PJO83/icenes/hw/icenes.kicad_pcb

## KiCad design hw/icenes.kicad_pcb (2019-10-22)

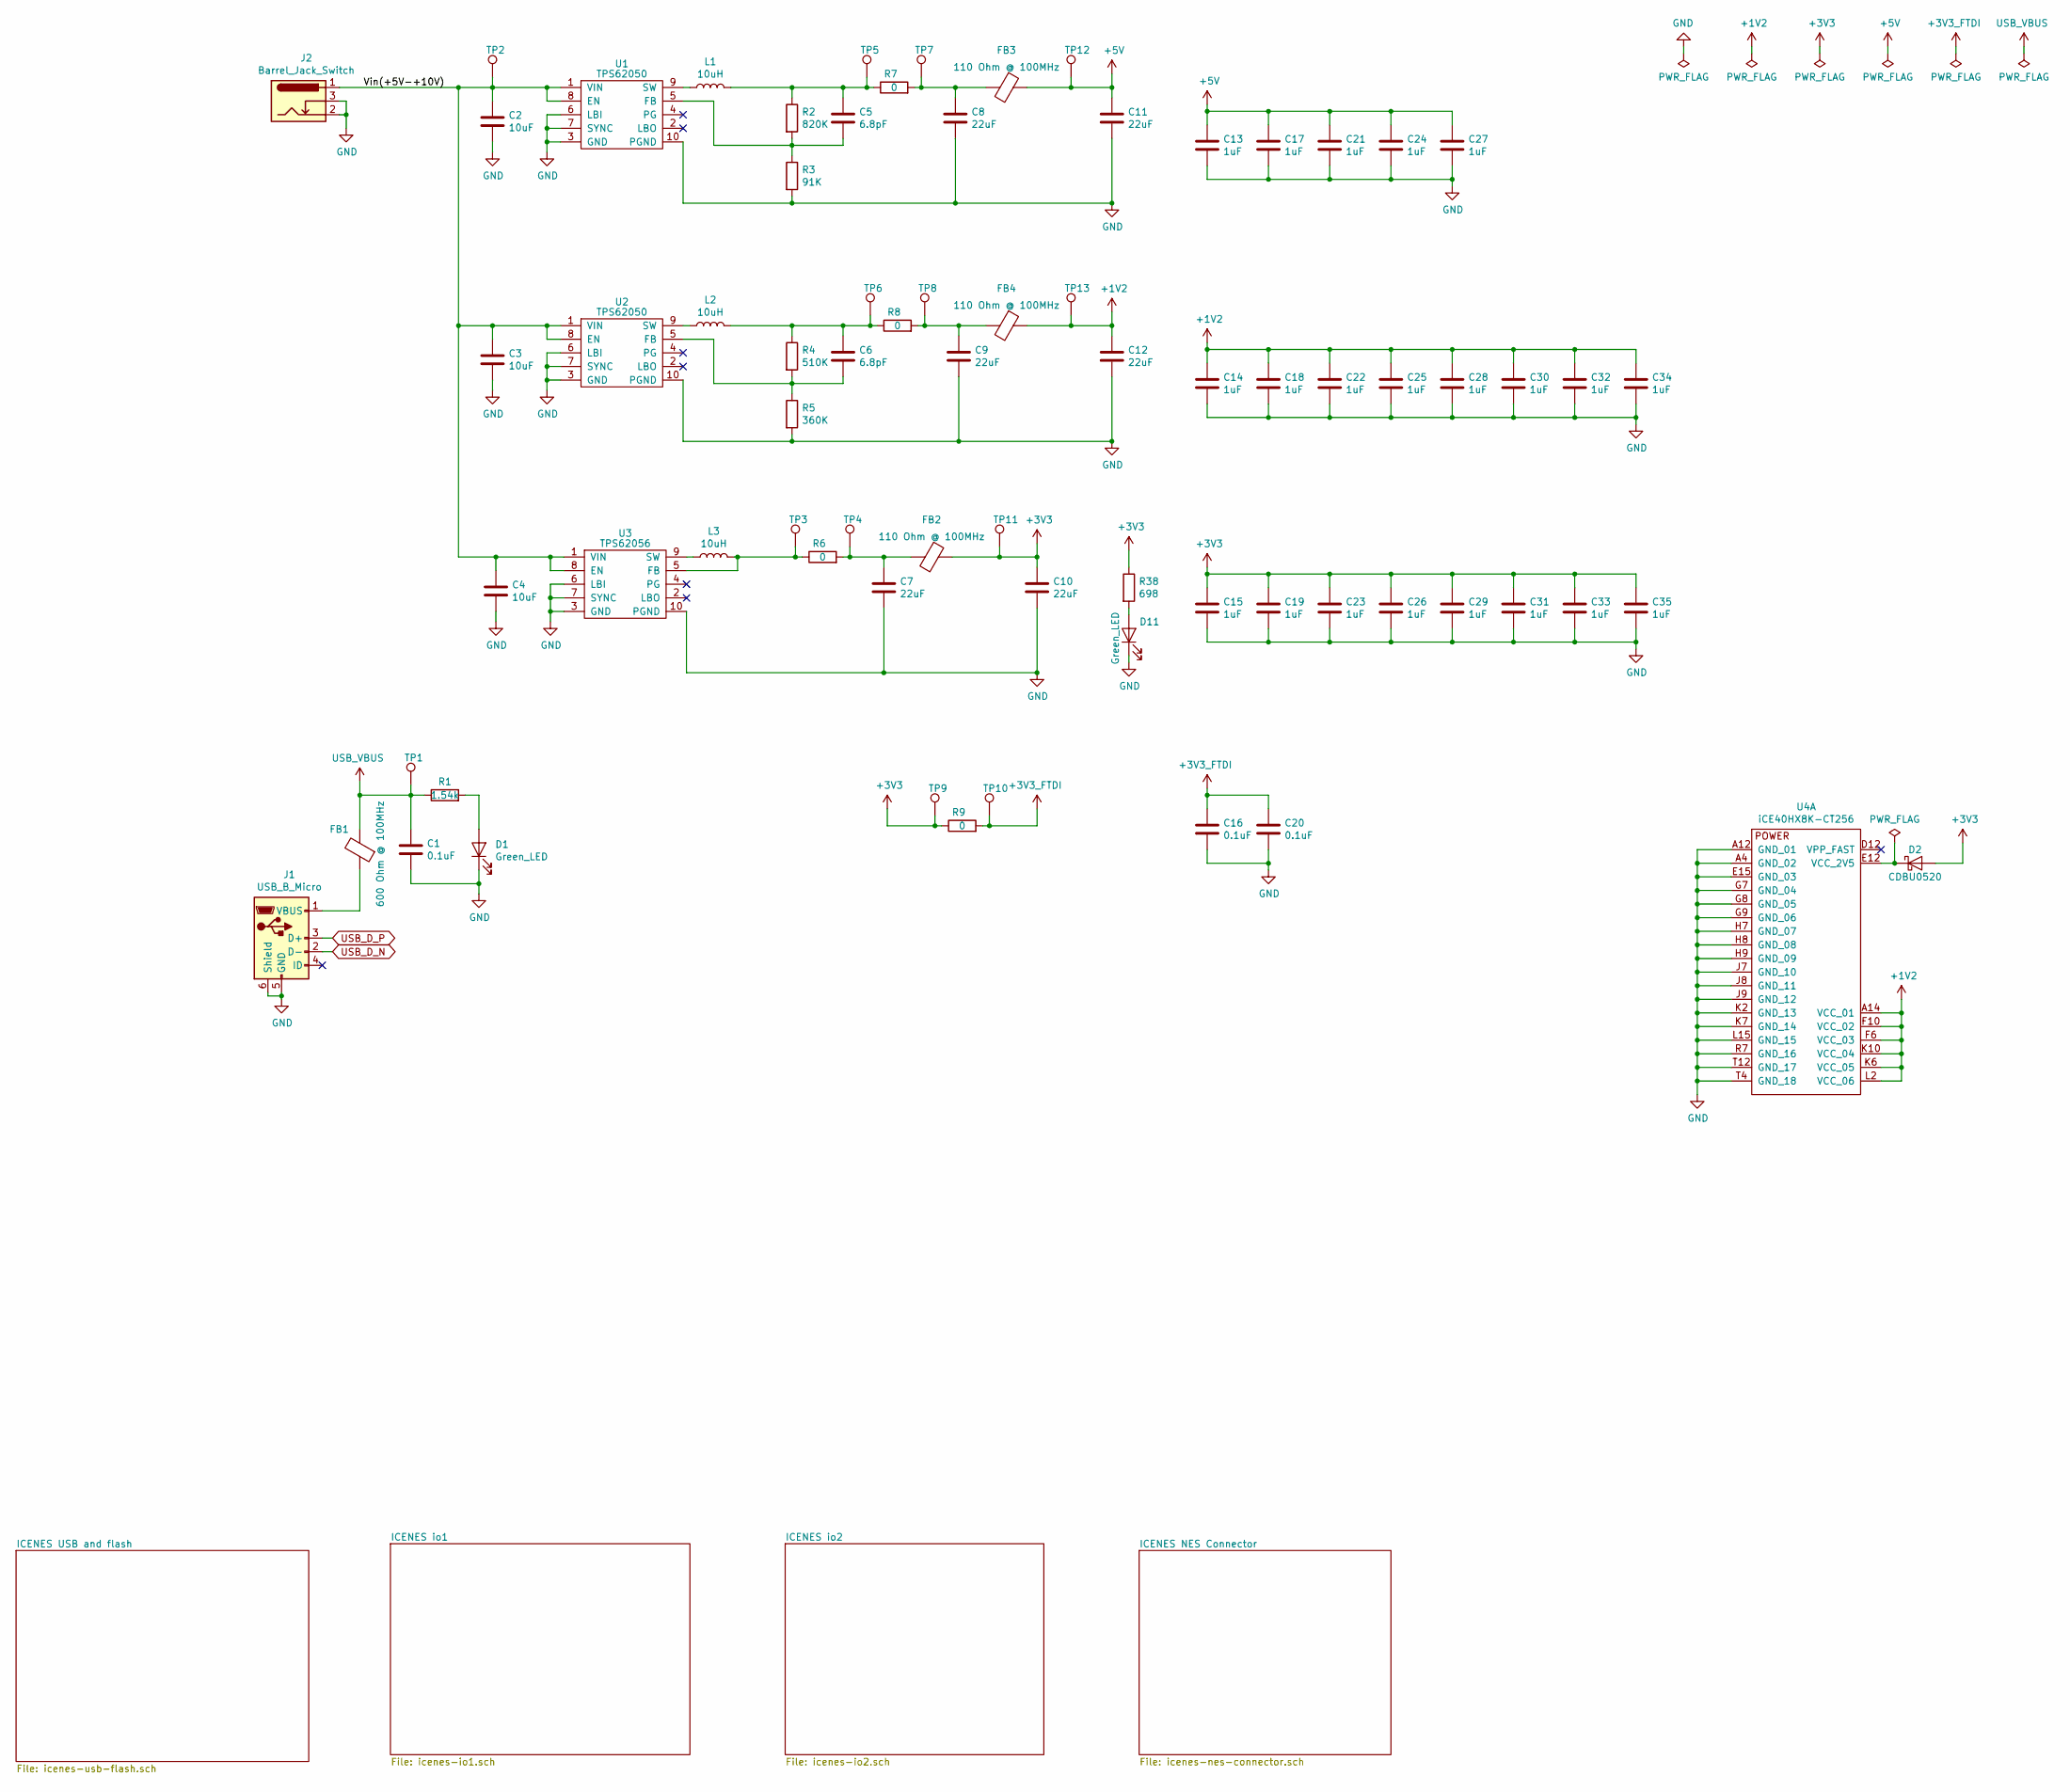
[picture p1: schematic icenes.sch, ICENES Power]

Parts:
C1, C16, C20: C0.1uF; C_0603_1608Metric_Pad1.05x0.95mm_HandSolder; Part number 885012206020
C2, C3, C4: C10uF; C_0603_1608Metric_Pad1.05x0.95mm_HandSolder; Part number GRM188R61A106KE69D
C5, C6: C6.8pF; C_0603_1608Metric_Pad1.05x0.95mm_HandSolder; Part number VJ0603A6R8DXQCW1BC
C7, C8, C9, C10, C11, C12: C22uF; C_0603_1608Metric_Pad1.05x0.95mm_HandSolder; Part number GRM188R61A226ME15D
C13, C14, C15, C17, C18, C19, C21, C22, C23, C24, C25, C26, C27, C28, C29, C30, C31, C32, C33, C34, C35: C1uF; C_0603_1608Metric_Pad1.05x0.95mm_HandSolder; Part number C0603C105K8PACTU
D1, D11: Green_LED; LED_0805_2012Metric_Pad1.15x1.40mm_HandSolder; Part number APTD2012LCGCK
D2: CDBU0520; D_0603_1608Metric_Pad1.05x0.95mm_HandSolder; Part number CDBU0520
FB1: FB600_500mA_0603; L_0603_1608Metric_Pad1.05x0.95mm_HandSolder; Part number KMZ1608BHR601CTDH5
FB2, FB3, FB4: FB110_4100mA_0603; L_0603_1608Metric_Pad1.05x0.95mm_HandSolder; Part number 74279228111
J1: USB_B_Micro; USB_Micro-B; Part number DX4R005JJ2R1800
J2: Barrel_Jack_Switch; BarrelJack_Horizontal; Part number 163-179PH-EX
L1, L2, L3: L10uH; Sumida_L_7.5x7.5_H4.5; Part number CDRH74NP-100MC-B
R1: R1.54k; R_0603_1608Metric_Pad1.05x0.95mm_HandSolder; Part number RC0603FR-071K54L
R2: R820K; R_0603_1608Metric_Pad1.05x0.95mm_HandSolder; Part number RC0603FR-07820KL
R3: R91K; R_0603_1608Metric_Pad1.05x0.95mm_HandSolder; Part number RC0603FR-0791KL
R4: R510K; R_0603_1608Metric_Pad1.05x0.95mm_HandSolder; Part number RC0603FR-07510KL
R5: R360K; R_0603_1608Metric_Pad1.05x0.95mm_HandSolder; Part number RC0603FR-07360KL
R6, R7, R8, R9: R0; R_0805_2012Metric_Pad1.15x1.40mm_HandSolder; Part number RC0805FR-070RL
R38: R698; R_0603_1608Metric_Pad1.05x0.95mm_HandSolder; Part number RC0603FR-07698RL
TP1, TP2, TP3, TP4, TP5, TP6, TP7, TP8, TP9, TP10, TP11, TP12, TP13: TestPoint; TestPoint_Pad_D1.0mm
U1, U2: TPS62050; VSSOP-10_3x3mm_P0.5mm; Part number TPS62050DGSR
U3: TPS62056; VSSOP-10_3x3mm_P0.5mm; Part number TPS62056DGSR
U4: iCE40HX8K-CT256; BGA-256_14.0x14.0mm_Layout16x16_P0.8mm_Ball0.45mm_Pad0.32mm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; Part number iCE40HX8K-CT256

Connections:
+1V2: C12.1, C14.1, C18.1, C22.1, C25.1, C28.1, C30.1, C32.1, C34.1, FB4.1, TP13.1, U4.A14 (VCC_01), U4.F6 (VCC_03), U4.F10 (VCC_02), U4.K6 (VCC_05), U4.K10 (VCC_04), U4.L2 (VCC_06); also elsewhere on the board
+3V3: C10.1, C15.1, C19.1, C23.1, C26.1, C29.1, C31.1, C33.1, C35.1, D2.2 (A), FB2.1, R9.1, R38.1, TP9.1, TP11.1; also elsewhere on the board
+3V3_FTDI: C16.1, C20.1, R9.2, TP10.1; also elsewhere on the board
+5V: C11.1, C13.1, C17.1, C21.1, C24.1, C27.1, FB3.1, TP12.1; also elsewhere on the board
/Vin(+5V-+10V): C2.1, C3.1, C4.1, J2.1, TP2.1, U1.1 (VIN), U1.8 (EN), U2.1 (VIN), U2.8 (EN), U3.1 (VIN), U3.8 (EN)
GND: C1.2, C2.2, C3.2, C4.2, C7.2, C8.2, C9.2, C10.2, C11.2, C12.2, C13.2, C14.2, C15.2, C16.2, C17.2, C18.2, C19.2, C20.2, C21.2, C22.2, C23.2, C24.2, C25.2, C26.2, C27.2, C28.2, C29.2, C30.2, C31.2, C32.2, C33.2, C34.2, C35.2, D1.1 (K), D11.1 (K), J1.5 (GND), J1.6 (Shield), J2.2, J2.3, R3.2, R5.2, U1.3 (GND), U1.6 (LBI), U1.7 (SYNC), U1.10 (PGND), U2.3 (GND), U2.6 (LBI), U2.7 (SYNC), U2.10 (PGND), U3.3 (GND), U3.6 (LBI), U3.7 (SYNC), U3.10 (PGND), U4.A4 (GND_02), U4.A12 (GND_01), U4.E15 (GND_03), U4.G7 (GND_04), U4.G8 (GND_05), U4.G9 (GND_06), U4.H7 (GND_07), U4.H8 (GND_08), U4.H9 (GND_09), U4.J7 (GND_10), U4.J8 (GND_11), U4.J9 (GND_12), U4.K2 (GND_13), U4.K7 (GND_14), U4.L15 (GND_15), U4.R7 (GND_16), U4.T4 (GND_18), U4.T12 (GND_17); also elsewhere on the board
unnamed: C5.1, L1.2, R2.1, R7.1, TP5.1
unnamed: C5.2, R2.2, R3.1, U1.5 (FB)
unnamed: C6.1, L2.2, R4.1, R8.1, TP6.1
unnamed: C6.2, R4.2, R5.1, U2.5 (FB)
unnamed: C7.1, FB2.2, R6.2, TP4.1
unnamed: C8.1, FB3.2, R7.2, TP7.1
unnamed: C9.1, FB4.2, R8.2, TP8.1
unnamed: D1.2 (A), R1.2
unnamed: D2.1 (K), U4.E12 (VCC_2V5)
unnamed: D11.2 (A), R38.2
unnamed: FB1.1, J1.1 (VBUS)
unnamed: L1.1, U1.9 (SW)
unnamed: L2.1, U2.9 (SW)
unnamed: L3.1, U3.9 (SW)
unnamed: L3.2, R6.1, TP3.1, U3.5 (FB)
USB_D_N: J1.2 (D-); also elsewhere on the board
USB_D_P: J1.3 (D+); also elsewhere on the board
USB_VBUS: C1.1, FB1.2, R1.1, TP1.1; also elsewhere on the board

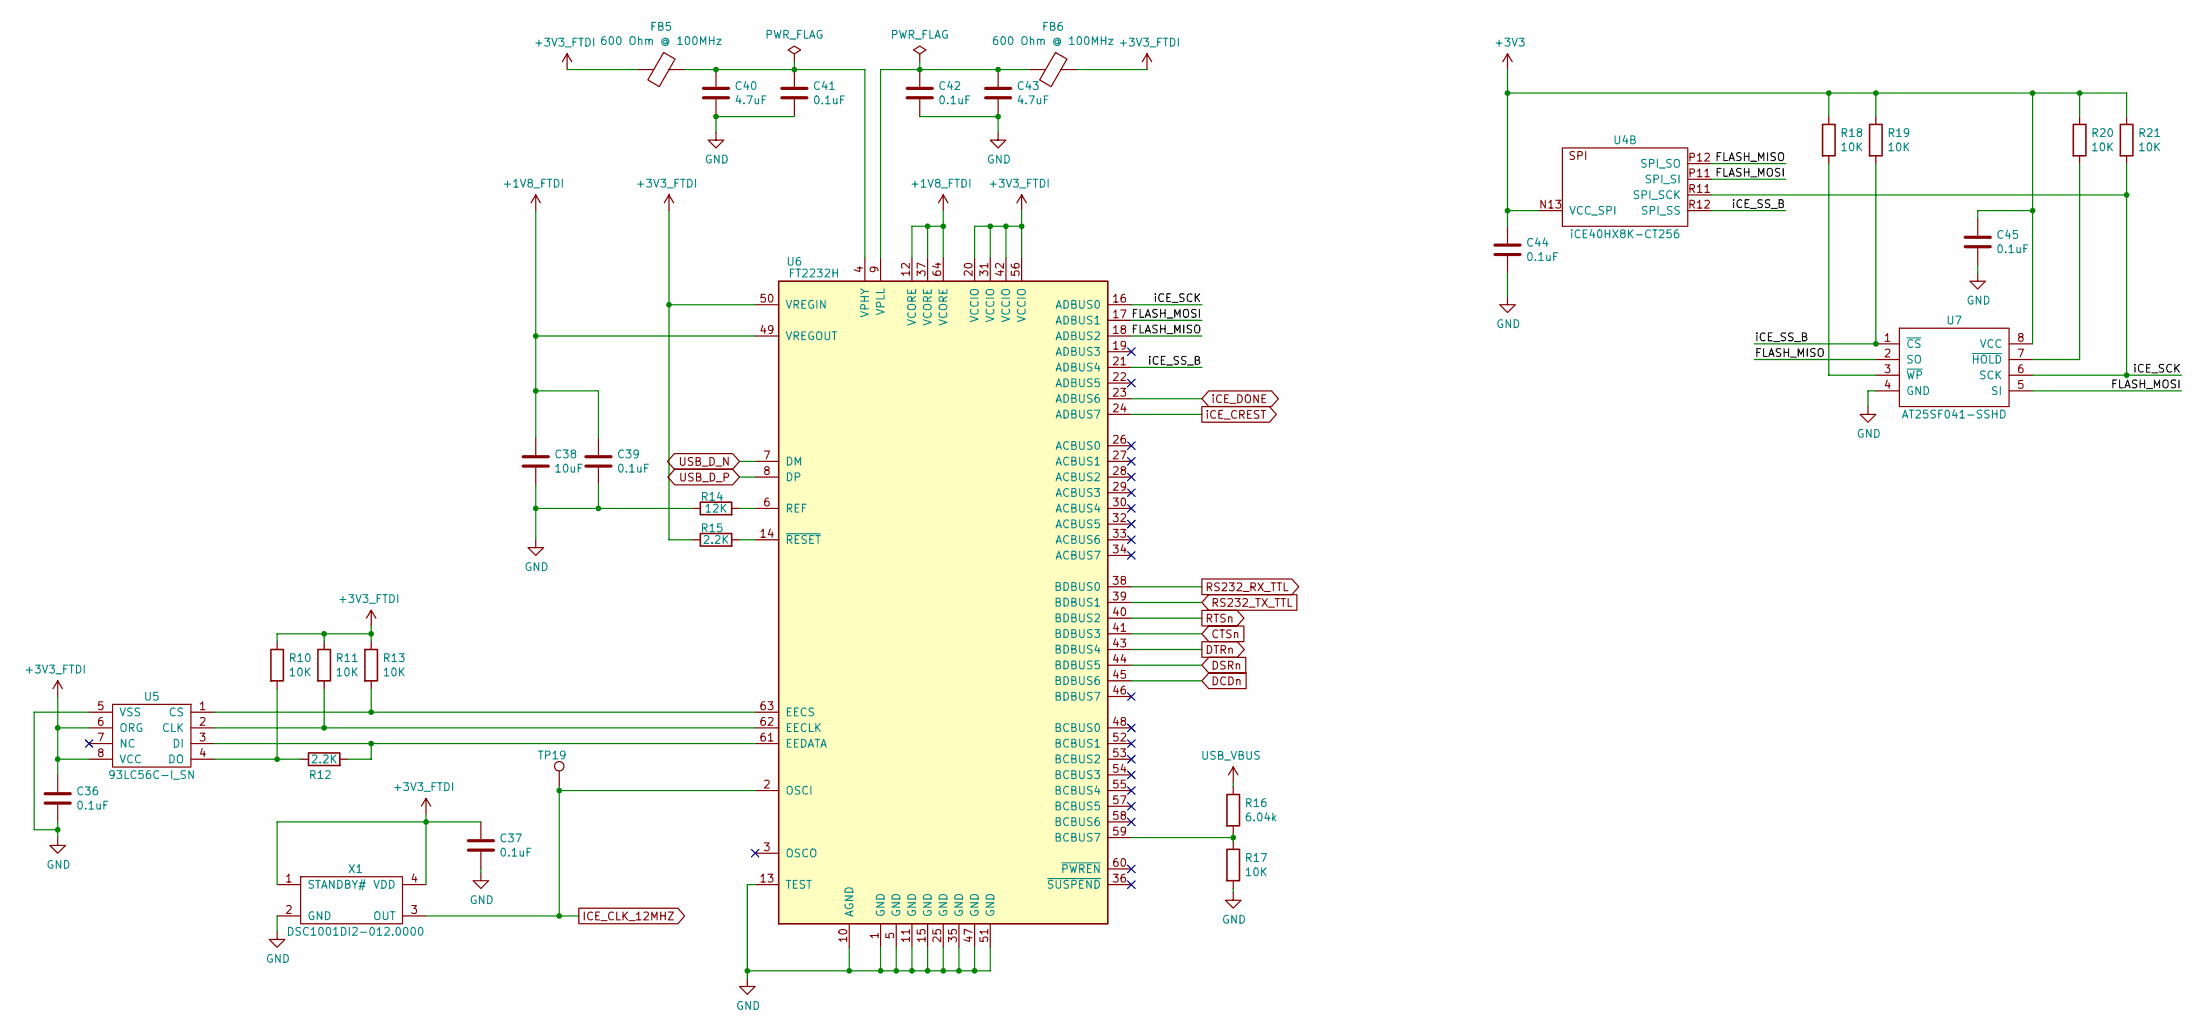
[picture p2: schematic icenes-usb-flash.sch]

Parts:
C36, C37, C39, C41, C42, C44, C45: C0.1uF; C_0603_1608Metric_Pad1.05x0.95mm_HandSolder; Part number 885012206020
C38: C10uF; C_0603_1608Metric_Pad1.05x0.95mm_HandSolder; Part number GRM188R61A106KE69D
C40, C43: C4.7uF; C_0603_1608Metric_Pad1.05x0.95mm_HandSolder; Part number LMK107BJ475KA-T
FB5, FB6: FB600_500mA_0603; L_0603_1608Metric_Pad1.05x0.95mm_HandSolder; Part number KMZ1608BHR601CTDH5
R10, R11, R13, R17, R18, R19, R20, R21: R10K; R_0603_1608Metric_Pad1.05x0.95mm_HandSolder; Part number RC0603FR-0710KL
R12, R15: R2.2K; R_0603_1608Metric_Pad1.05x0.95mm_HandSolder; Part number RC0603FR-072K2L
R14: R12K; R_0603_1608Metric_Pad1.05x0.95mm_HandSolder; Part number RC0603FR-0712KL
R16: R6.04k; R_0603_1608Metric_Pad1.05x0.95mm_HandSolder; Part number RC0603FR-076K04L
TP19: TestPoint; TestPoint_Pad_D1.0mm
U4: iCE40HX8K-CT256; BGA-256_14.0x14.0mm_Layout16x16_P0.8mm_Ball0.45mm_Pad0.32mm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; Part number iCE40HX8K-CT256
U5: 93LC56C-I_SN; SOIC-8_3.9x4.9mm_P1.27mm; Part number 93LC56C-I/SN
U6: FT2232H; LQFP-64_10x10mm_P0.5mm; Part number FT2232HL
U7: AT25SF041-SSHD; SOIC-8_3.9x4.9mm_P1.27mm; Part number AT25SF041-SSHD-B
X1: DSC1001DI2-012.0000; MEMS_Microship_Ocillator_SMD_CDFN-4_2.5x2.0mm; Part number DSC1001DI2-012.0000T

Connections:
+1V8_FTDI: C38.1, C39.1, U6.12 (VCORE), U6.37 (VCORE), U6.49 (VREGOUT), U6.64 (VCORE)
+3V3: C44.1, C45.1, R18.1, R19.1, R20.1, R21.1, U4.N13 (VCC_SPI), U7.8 (VCC); also elsewhere on the board
+3V3_FTDI: C36.1, C37.1, FB5.2, FB6.1, R10.1, R11.1, R13.1, R15.1, U5.6 (ORG), U5.8 (VCC), U6.20 (VCCIO), U6.31 (VCCIO), U6.42 (VCCIO), U6.50 (VREGIN), U6.56 (VCCIO), X1.1 (STANDBY#), X1.4 (VDD); also elsewhere on the board
/ICENES USB and flash/FLASH_MISO: U4.P12 (SPI_SO), U6.18 (ADBUS2), U7.2 (SO)
/ICENES USB and flash/FLASH_MOSI: U4.P11 (SPI_SI), U6.17 (ADBUS1), U7.5 (SI)
/ICENES USB and flash/iCE_SCK: R21.2, U4.R11 (SPI_SCK), U6.16 (ADBUS0), U7.6 (SCK)
/ICENES USB and flash/iCE_SS_B: R19.2, U4.R12 (SPI_SS), U6.21 (ADBUS4), U7.1 (~CS)
CTSn: U6.41 (BDBUS3); also elsewhere on the board
DCDn: U6.45 (BDBUS6); also elsewhere on the board
DSRn: U6.44 (BDBUS5); also elsewhere on the board
DTRn: U6.43 (BDBUS4); also elsewhere on the board
GND: C36.2, C37.2, C38.2, C39.2, C40.2, C41.2, C42.2, C43.2, C44.2, C45.2, R14.1, R17.2, U5.5 (VSS), U6.1 (GND), U6.5 (GND), U6.10 (AGND), U6.11 (GND), U6.13 (TEST), U6.15 (GND), U6.25 (GND), U6.35 (GND), U6.47 (GND), U6.51 (GND), U7.4 (GND), X1.2 (GND); also elsewhere on the board
ICE_CLK_12MHZ: TP19.1, U6.2 (OSCI), X1.3 (OUT); also elsewhere on the board
unnamed: C40.1, C41.1, FB5.1, U6.4 (VPHY)
unnamed: C42.1, C43.1, FB6.2, U6.9 (VPLL)
unnamed: R10.2, R12.1, U5.4 (DO)
unnamed: R11.2, U5.2 (CLK), U6.62 (EECLK)
unnamed: R12.2, U5.3 (DI), U6.61 (EEDATA)
unnamed: R13.2, U5.1 (CS), U6.63 (EECS)
unnamed: R14.2, U6.6 (REF)
unnamed: R15.2, U6.14 (~RESET)
unnamed: R16.2, R17.1, U6.59 (BCBUS7)
unnamed: R18.2, U7.3 (~WP)
unnamed: R20.2, U7.7 (~HOLD)
RS232_RX_TTL: U6.38 (BDBUS0); also elsewhere on the board
RS232_TX_TTL: U6.39 (BDBUS1); also elsewhere on the board
RTSn: U6.40 (BDBUS2); also elsewhere on the board
USB_D_N: U6.7 (DM); also elsewhere on the board
USB_D_P: U6.8 (DP); also elsewhere on the board
USB_VBUS: R16.1; also elsewhere on the board
iCE_CREST: U6.24 (ADBUS7); also elsewhere on the board
iCE_DONE: U6.23 (ADBUS6); also elsewhere on the board

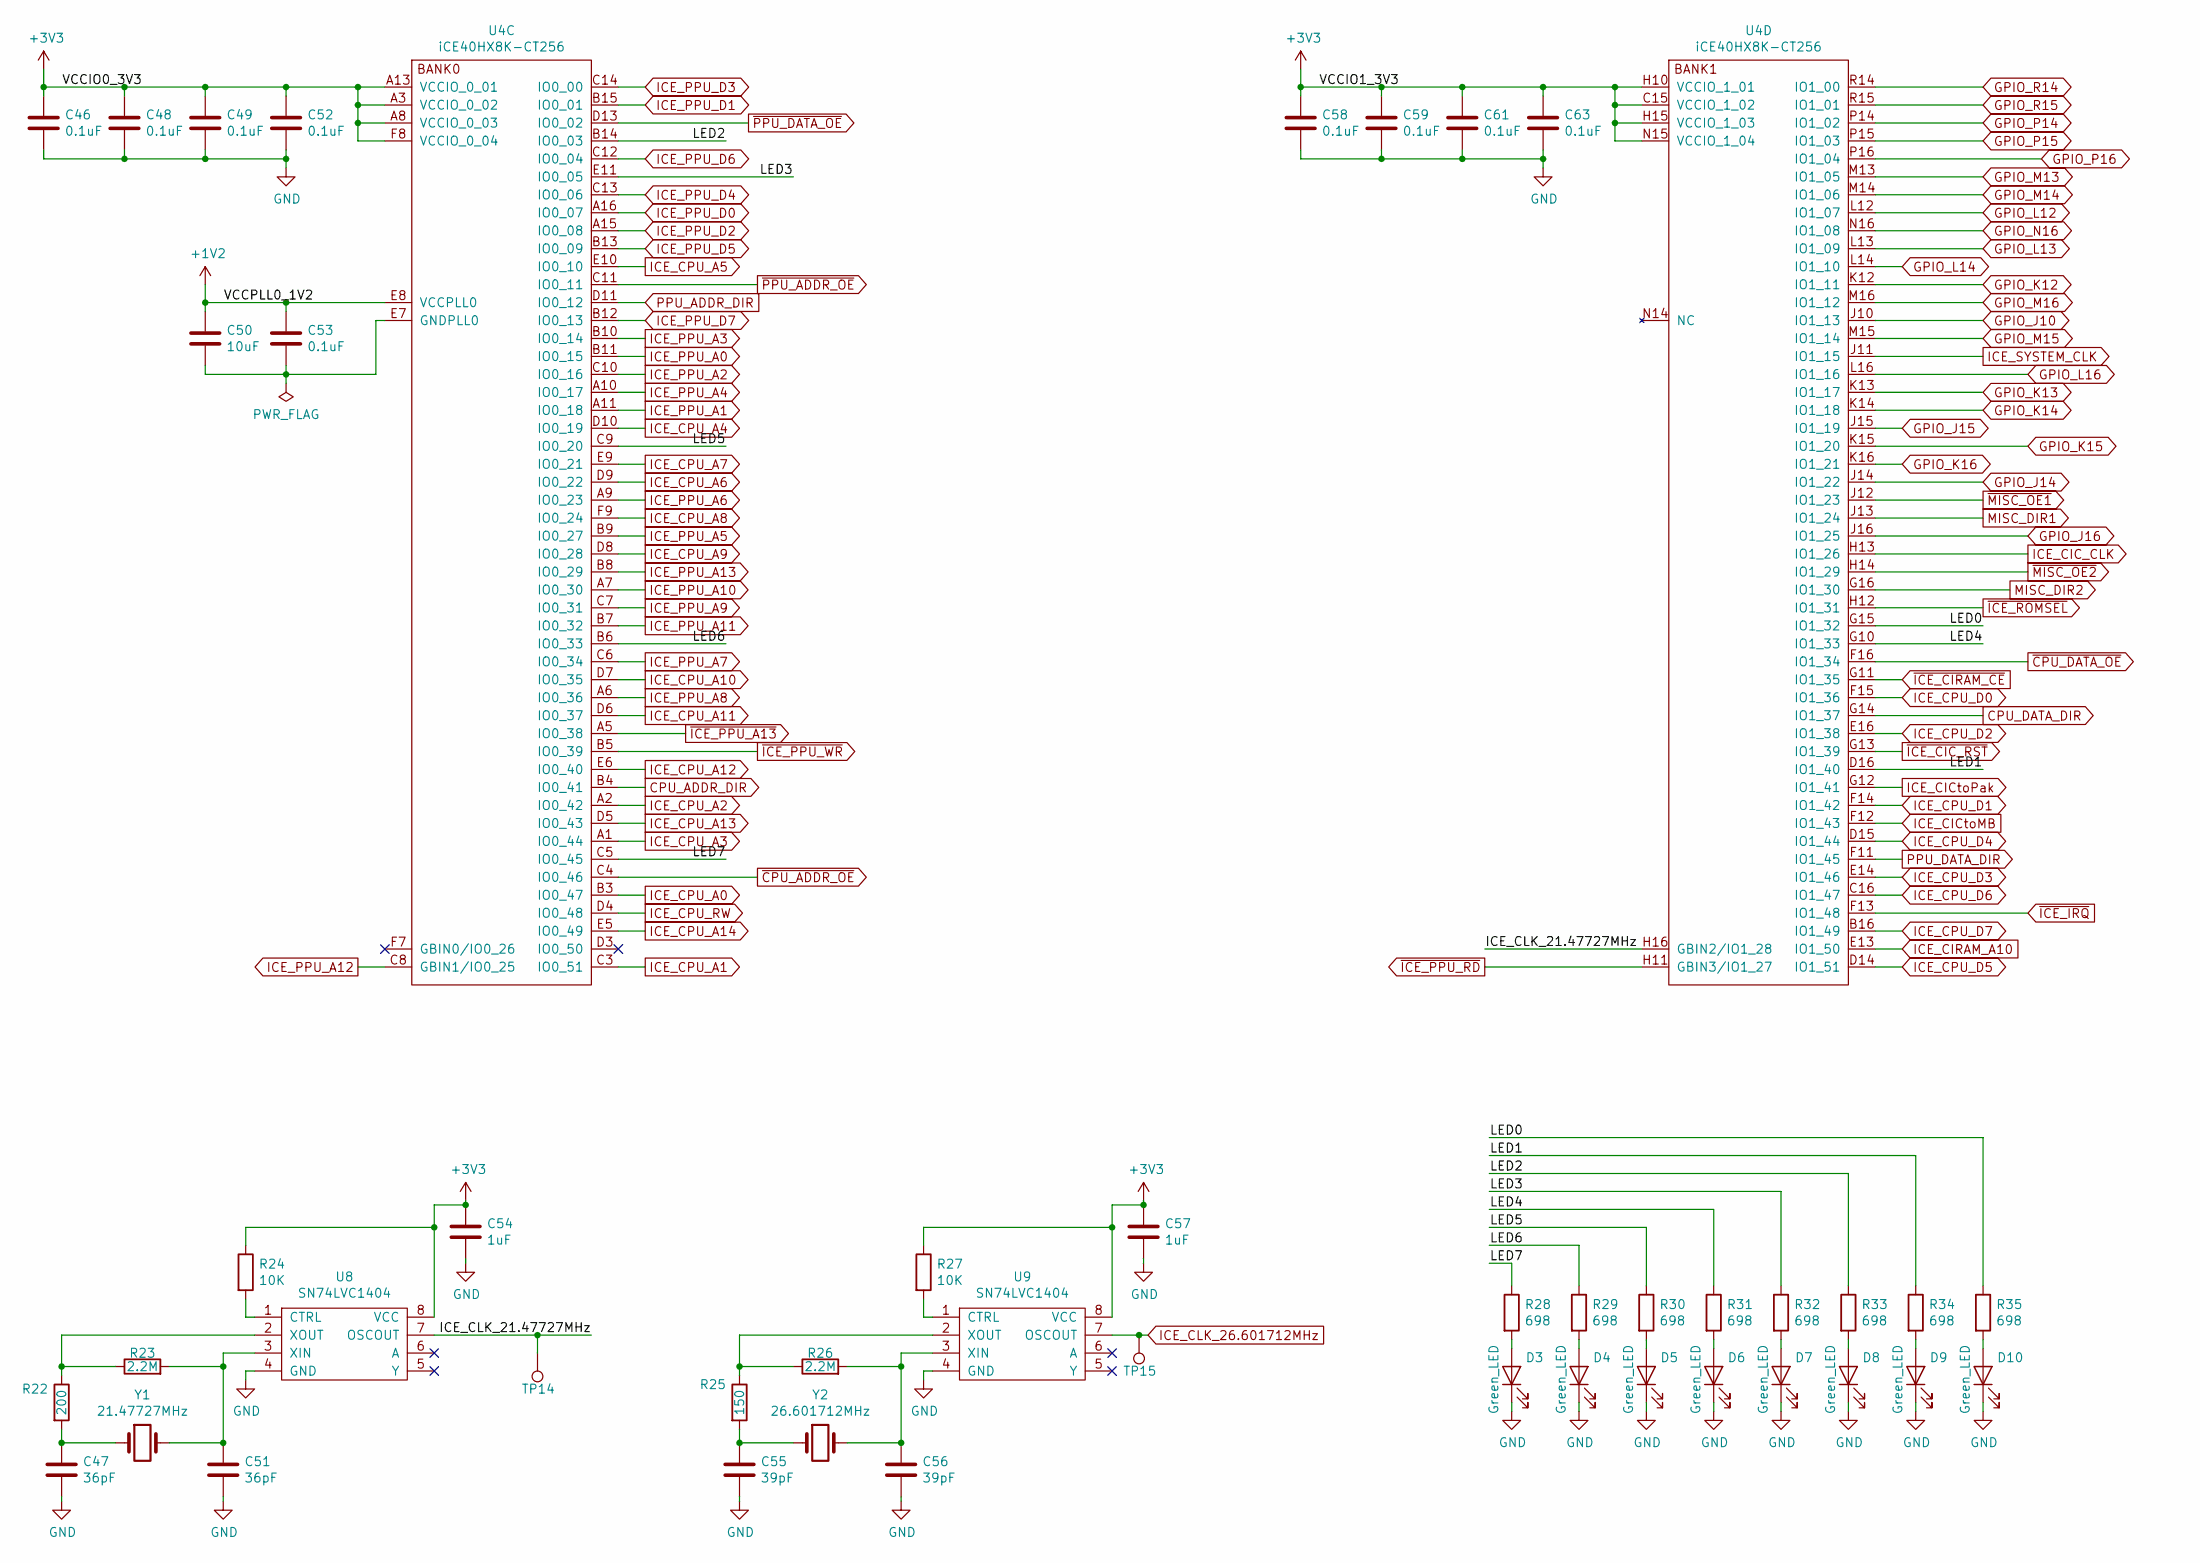
[picture p3: schematic icenes-io1.sch]

Parts:
C46, C48, C49, C52, C53, C58, C59, C61, C63: C0.1uF; C_0603_1608Metric_Pad1.05x0.95mm_HandSolder; Part number 885012206020
C47, C51: C36pF; C_0603_1608Metric_Pad1.05x0.95mm_HandSolder; Part number CC0603FRNPO9BN360
C50: C10uF; C_0603_1608Metric_Pad1.05x0.95mm_HandSolder; Part number GRM188R61A106KE69D
C54, C57: C1uF; C_0603_1608Metric_Pad1.05x0.95mm_HandSolder; Part number C0603C105K8PACTU
C55, C56: C39pF; C_0603_1608Metric_Pad1.05x0.95mm_HandSolder; Part number CC0603FRNPO9BN390
D3, D4, D5, D6, D7, D8, D9, D10: Green_LED; LED_0805_2012Metric_Pad1.15x1.40mm_HandSolder; Part number APTD2012LCGCK
R22: R200; R_0603_1608Metric_Pad1.05x0.95mm_HandSolder; Part number RC0603FR-07200RL
R23, R26: R2.2M; R_0603_1608Metric_Pad1.05x0.95mm_HandSolder; Part number RC0603FR-072M2L
R24, R27: R10K; R_0603_1608Metric_Pad1.05x0.95mm_HandSolder; Part number RC0603FR-0710KL
R25: R150; R_0603_1608Metric_Pad1.05x0.95mm_HandSolder; Part number RC0603FR-07150RL
R28, R29, R30, R31, R32, R33, R34, R35: R698; R_0603_1608Metric_Pad1.05x0.95mm_HandSolder; Part number RC0603FR-07698RL
TP14, TP15: TestPoint; TestPoint_Pad_D1.0mm
U4: iCE40HX8K-CT256; BGA-256_14.0x14.0mm_Layout16x16_P0.8mm_Ball0.45mm_Pad0.32mm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; Part number iCE40HX8K-CT256
U8, U9: SN74LVC1404; VSSOP-8_2.3x2mm_P0.5mm; Part number SN74LVC1404DCUR
Y1: 21.47727MHz; Crystal_HC49-4H_Vertical; Part number HC-49/U-S21477270ABJB
Y2: 26.601712MHz; Crystal_HC49-4H_Vertical; Part number ?

Connections:
+1V2: C50.1, C53.1, U4.E8 (VCCPLL0); also elsewhere on the board
+3V3: C46.1, C48.1, C49.1, C52.1, C54.1, C57.1, C58.1, C59.1, C61.1, C63.1, R24.1, R27.1, U4.A3 (VCCIO_0_02), U4.A8 (VCCIO_0_03), U4.A13 (VCCIO_0_01), U4.C15 (VCCIO_1_02), U4.F8 (VCCIO_0_04), U4.H10 (VCCIO_1_01), U4.H15 (VCCIO_1_03), U4.N15 (VCCIO_1_04), U8.8 (VCC), U9.8 (VCC); also elsewhere on the board
/ICENES io1/ICE_CLK_21.47727MHz: TP14.1, U4.H16 (GBIN2/IO1_28), U8.7 (OSCOUT)
/ICENES io1/LED0: R35.1, U4.G15 (IO1_32)
/ICENES io1/LED1: R34.1, U4.D16 (IO1_40)
/ICENES io1/LED2: R33.1, U4.B14 (IO0_03)
/ICENES io1/LED3: R32.1, U4.E11 (IO0_05)
/ICENES io1/LED4: R31.1, U4.G10 (IO1_33)
/ICENES io1/LED5: R30.1, U4.C9 (IO0_20)
/ICENES io1/LED6: R29.1, U4.B6 (IO0_33)
/ICENES io1/LED7: R28.1, U4.C5 (IO0_45)
CPU_ADDR_DIR: U4.B4 (IO0_41); also elsewhere on the board
CPU_DATA_DIR: U4.G14 (IO1_37); also elsewhere on the board
GND: C46.2, C47.2, C48.2, C49.2, C51.2, C52.2, C54.2, C55.2, C56.2, C57.2, C58.2, C59.2, C61.2, C63.2, D3.1 (K), D4.1 (K), D5.1 (K), D6.1 (K), D7.1 (K), D8.1 (K), D9.1 (K), D10.1 (K), U8.4 (GND), U9.4 (GND); also elsewhere on the board
GPIO_J10: U4.J10 (IO1_13); also elsewhere on the board
GPIO_J14: U4.J14 (IO1_22); also elsewhere on the board
GPIO_J15: U4.J15 (IO1_19); also elsewhere on the board
GPIO_J16: U4.J16 (IO1_25); also elsewhere on the board
GPIO_K12: U4.K12 (IO1_11); also elsewhere on the board
GPIO_K13: U4.K13 (IO1_17); also elsewhere on the board
GPIO_K14: U4.K14 (IO1_18); also elsewhere on the board
GPIO_K15: U4.K15 (IO1_20); also elsewhere on the board
GPIO_K16: U4.K16 (IO1_21); also elsewhere on the board
GPIO_L12: U4.L12 (IO1_07); also elsewhere on the board
GPIO_L13: U4.L13 (IO1_09); also elsewhere on the board
GPIO_L14: U4.L14 (IO1_10); also elsewhere on the board
GPIO_L16: U4.L16 (IO1_16); also elsewhere on the board
GPIO_M13: U4.M13 (IO1_05); also elsewhere on the board
GPIO_M14: U4.M14 (IO1_06); also elsewhere on the board
GPIO_M15: U4.M15 (IO1_14); also elsewhere on the board
GPIO_M16: U4.M16 (IO1_12); also elsewhere on the board
GPIO_N16: U4.N16 (IO1_08); also elsewhere on the board
GPIO_P14: U4.P14 (IO1_02); also elsewhere on the board
GPIO_P15: U4.P15 (IO1_03); also elsewhere on the board
GPIO_P16: U4.P16 (IO1_04); also elsewhere on the board
GPIO_R14: U4.R14 (IO1_00); also elsewhere on the board
GPIO_R15: U4.R15 (IO1_01); also elsewhere on the board
ICE_CIC_CLK: U4.H13 (IO1_26); also elsewhere on the board
ICE_CICtoMB: U4.F12 (IO1_43); also elsewhere on the board
ICE_CICtoPak: U4.G12 (IO1_41); also elsewhere on the board
ICE_CIRAM_A10: U4.E13 (IO1_50); also elsewhere on the board
ICE_CLK_26.601712MHz: TP15.1, U9.7 (OSCOUT); also elsewhere on the board
ICE_CPU_A0: U4.B3 (IO0_47); also elsewhere on the board
ICE_CPU_A1: U4.C3 (IO0_51); also elsewhere on the board
ICE_CPU_A2: U4.A2 (IO0_42); also elsewhere on the board
ICE_CPU_A3: U4.A1 (IO0_44); also elsewhere on the board
ICE_CPU_A4: U4.D10 (IO0_19); also elsewhere on the board
ICE_CPU_A5: U4.E10 (IO0_10); also elsewhere on the board
ICE_CPU_A6: U4.D9 (IO0_22); also elsewhere on the board
ICE_CPU_A7: U4.E9 (IO0_21); also elsewhere on the board
ICE_CPU_A8: U4.F9 (IO0_24); also elsewhere on the board
ICE_CPU_A9: U4.D8 (IO0_28); also elsewhere on the board
ICE_CPU_A10: U4.D7 (IO0_35); also elsewhere on the board
ICE_CPU_A11: U4.D6 (IO0_37); also elsewhere on the board
ICE_CPU_A12: U4.E6 (IO0_40); also elsewhere on the board
ICE_CPU_A13: U4.D5 (IO0_43); also elsewhere on the board
ICE_CPU_A14: U4.E5 (IO0_49); also elsewhere on the board
ICE_CPU_D0: U4.F15 (IO1_36); also elsewhere on the board
ICE_CPU_D1: U4.F14 (IO1_42); also elsewhere on the board
ICE_CPU_D2: U4.E16 (IO1_38); also elsewhere on the board
ICE_CPU_D3: U4.E14 (IO1_46); also elsewhere on the board
ICE_CPU_D4: U4.D15 (IO1_44); also elsewhere on the board
ICE_CPU_D5: U4.D14 (IO1_51); also elsewhere on the board
ICE_CPU_D6: U4.C16 (IO1_47); also elsewhere on the board
ICE_CPU_D7: U4.B16 (IO1_49); also elsewhere on the board
ICE_CPU_RW: U4.D4 (IO0_48); also elsewhere on the board
ICE_PPU_A0: U4.B11 (IO0_15); also elsewhere on the board
ICE_PPU_A1: U4.A11 (IO0_18); also elsewhere on the board
ICE_PPU_A2: U4.C10 (IO0_16); also elsewhere on the board
ICE_PPU_A3: U4.B10 (IO0_14); also elsewhere on the board
ICE_PPU_A4: U4.A10 (IO0_17); also elsewhere on the board
ICE_PPU_A5: U4.B9 (IO0_27); also elsewhere on the board
ICE_PPU_A6: U4.A9 (IO0_23); also elsewhere on the board
ICE_PPU_A7: U4.C6 (IO0_34); also elsewhere on the board
ICE_PPU_A8: U4.A6 (IO0_36); also elsewhere on the board
ICE_PPU_A9: U4.C7 (IO0_31); also elsewhere on the board
ICE_PPU_A10: U4.A7 (IO0_30); also elsewhere on the board
ICE_PPU_A11: U4.B7 (IO0_32); also elsewhere on the board
ICE_PPU_A12: U4.C8 (GBIN1/IO0_25); also elsewhere on the board
ICE_PPU_A13: U4.B8 (IO0_29); also elsewhere on the board
ICE_PPU_D0: U4.A16 (IO0_07); also elsewhere on the board
ICE_PPU_D1: U4.B15 (IO0_01); also elsewhere on the board
ICE_PPU_D2: U4.A15 (IO0_08); also elsewhere on the board
ICE_PPU_D3: U4.C14 (IO0_00); also elsewhere on the board
ICE_PPU_D4: U4.C13 (IO0_06); also elsewhere on the board
ICE_PPU_D5: U4.B13 (IO0_09); also elsewhere on the board
ICE_PPU_D6: U4.C12 (IO0_04); also elsewhere on the board
ICE_PPU_D7: U4.B12 (IO0_13); also elsewhere on the board
ICE_SYSTEM_CLK: U4.J11 (IO1_15); also elsewhere on the board
MISC_DIR1: U4.J13 (IO1_24); also elsewhere on the board
MISC_DIR2: U4.G16 (IO1_30); also elsewhere on the board
unnamed: C47.1, R22.2, Y1.1
unnamed: C50.2, C53.2, U4.E7 (GNDPLL0)
unnamed: C51.1, R23.2, U8.3 (XIN), Y1.2
unnamed: C55.1, R25.2, Y2.1
unnamed: C56.1, R26.2, U9.3 (XIN), Y2.2
unnamed: D3.2 (A), R28.2
unnamed: D4.2 (A), R29.2
unnamed: D5.2 (A), R30.2
unnamed: D6.2 (A), R31.2
unnamed: D7.2 (A), R32.2
unnamed: D8.2 (A), R33.2
unnamed: D9.2 (A), R34.2
unnamed: D10.2 (A), R35.2
unnamed: R22.1, R23.1, U8.2 (XOUT)
unnamed: R24.2, U8.1 (CTRL)
unnamed: R25.1, R26.1, U9.2 (XOUT)
unnamed: R27.2, U9.1 (CTRL)
PPU_ADDR_DIR: U4.D11 (IO0_12); also elsewhere on the board
PPU_DATA_DIR: U4.F11 (IO1_45); also elsewhere on the board
~CPU_ADDR_OE: U4.C4 (IO0_46); also elsewhere on the board
~CPU_DATA_OE: U4.F16 (IO1_34); also elsewhere on the board
~ICE_CIC_RST: U4.G13 (IO1_39); also elsewhere on the board
~ICE_CIRAM_CE: U4.G11 (IO1_35); also elsewhere on the board
~ICE_IRQ: U4.F13 (IO1_48); also elsewhere on the board
~ICE_PPU_A13: U4.A5 (IO0_38); also elsewhere on the board
~ICE_PPU_RD: U4.H11 (GBIN3/IO1_27); also elsewhere on the board
~ICE_PPU_WR: U4.B5 (IO0_39); also elsewhere on the board
~ICE_ROMSEL: U4.H12 (IO1_31); also elsewhere on the board
~MISC_OE1: U4.J12 (IO1_23); also elsewhere on the board
~MISC_OE2: U4.H14 (IO1_29); also elsewhere on the board
~PPU_ADDR_OE: U4.C11 (IO0_11); also elsewhere on the board
~PPU_DATA_OE: U4.D13 (IO0_02); also elsewhere on the board
