PJO83/icenes/hw/icenes.kicad_pcb

## KiCad design hw/icenes.kicad_pcb (continued)

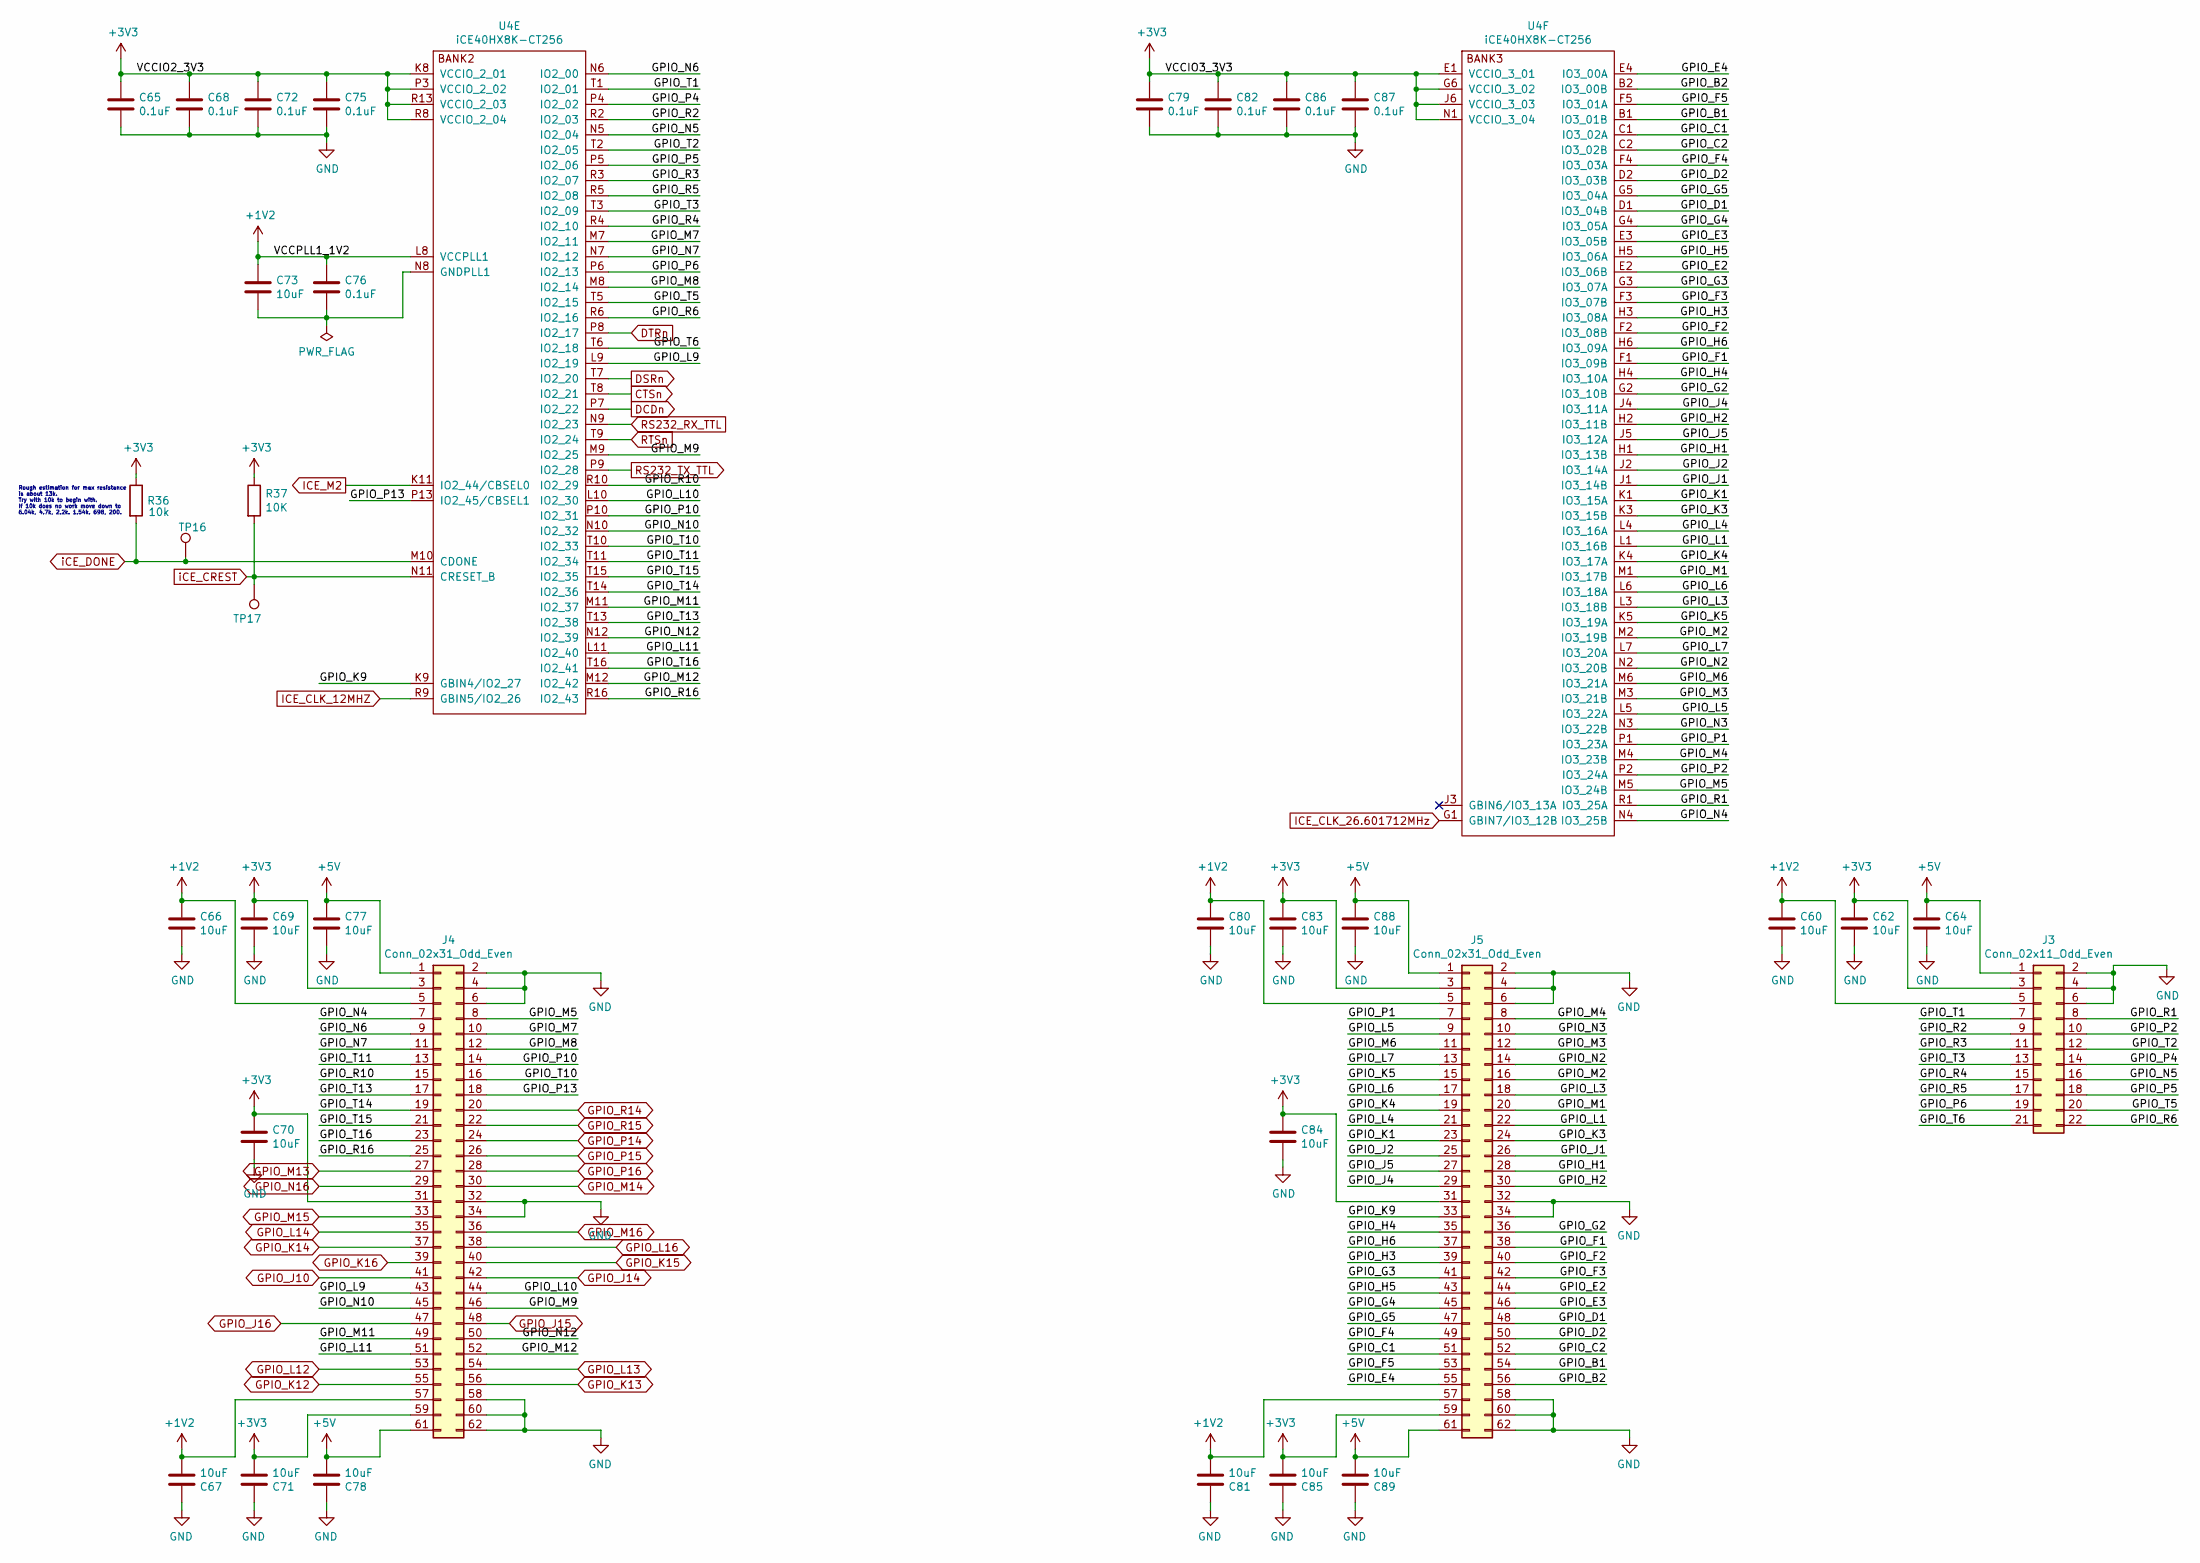
[picture p4: schematic icenes-io2.sch]

Parts:
C60, C62, C64, C66, C67, C69, C70, C71, C73, C77, C78, C80, C81, C83, C84, C85, C88, C89: C10uF; C_0603_1608Metric_Pad1.05x0.95mm_HandSolder; Part number GRM188R61A106KE69D
C65, C68, C72, C75, C76, C79, C82, C86, C87: C0.1uF; C_0603_1608Metric_Pad1.05x0.95mm_HandSolder; Part number 885012206020
J3: Conn_02x11_Odd_Even; PinSocket_2x11_P2.54mm_Vertical; Part number SSQ-111-02-T-D
J4, J5: Conn_02x31_Odd_Even; PinSocket_2x31_P2.54mm_Vertical; Part number 61306421821
R36, R37: R10K; R_0603_1608Metric_Pad1.05x0.95mm_HandSolder; Part number RC0603FR-0710KL
TP16, TP17: TestPoint; TestPoint_Pad_D1.0mm
U4: iCE40HX8K-CT256; BGA-256_14.0x14.0mm_Layout16x16_P0.8mm_Ball0.45mm_Pad0.32mm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; Part number iCE40HX8K-CT256

Connections:
+1V2: C60.1, C66.1, C67.2, C73.1, C76.1, C80.1, C81.2, J3.5, J4.5, J4.57, J5.5, J5.57, U4.L8 (VCCPLL1); also elsewhere on the board
+3V3: C62.1, C65.1, C68.1, C69.1, C70.1, C71.2, C72.1, C75.1, C79.1, C82.1, C83.1, C84.1, C85.2, C86.1, C87.1, J3.3, J4.3, J4.31, J4.59, J5.3, J5.31, J5.59, R36.1, R37.1, U4.E1 (VCCIO_3_01), U4.G6 (VCCIO_3_02), U4.J6 (VCCIO_3_03), U4.K8 (VCCIO_2_01), U4.N1 (VCCIO_3_04), U4.P3 (VCCIO_2_02), U4.R8 (VCCIO_2_04), U4.R13 (VCCIO_2_03); also elsewhere on the board
+5V: C64.1, C77.1, C78.2, C88.1, C89.2, J3.1, J4.1, J4.61, J5.1, J5.61; also elsewhere on the board
/ICENES io2/GPIO_B1: J5.54, U4.B1 (IO3_01B)
/ICENES io2/GPIO_B2: J5.56, U4.B2 (IO3_00B)
/ICENES io2/GPIO_C1: J5.51, U4.C1 (IO3_02A)
/ICENES io2/GPIO_C2: J5.52, U4.C2 (IO3_02B)
/ICENES io2/GPIO_D1: J5.48, U4.D1 (IO3_04B)
/ICENES io2/GPIO_D2: J5.50, U4.D2 (IO3_03B)
/ICENES io2/GPIO_E2: J5.44, U4.E2 (IO3_06B)
/ICENES io2/GPIO_E3: J5.46, U4.E3 (IO3_05B)
/ICENES io2/GPIO_E4: J5.55, U4.E4 (IO3_00A)
/ICENES io2/GPIO_F1: J5.38, U4.F1 (IO3_09B)
/ICENES io2/GPIO_F2: J5.40, U4.F2 (IO3_08B)
/ICENES io2/GPIO_F3: J5.42, U4.F3 (IO3_07B)
/ICENES io2/GPIO_F4: J5.49, U4.F4 (IO3_03A)
/ICENES io2/GPIO_F5: J5.53, U4.F5 (IO3_01A)
/ICENES io2/GPIO_G2: J5.36, U4.G2 (IO3_10B)
/ICENES io2/GPIO_G3: J5.41, U4.G3 (IO3_07A)
/ICENES io2/GPIO_G4: J5.45, U4.G4 (IO3_05A)
/ICENES io2/GPIO_G5: J5.47, U4.G5 (IO3_04A)
/ICENES io2/GPIO_H1: J5.28, U4.H1 (IO3_13B)
/ICENES io2/GPIO_H2: J5.30, U4.H2 (IO3_11B)
/ICENES io2/GPIO_H3: J5.39, U4.H3 (IO3_08A)
/ICENES io2/GPIO_H4: J5.35, U4.H4 (IO3_10A)
/ICENES io2/GPIO_H5: J5.43, U4.H5 (IO3_06A)
/ICENES io2/GPIO_H6: J5.37, U4.H6 (IO3_09A)
/ICENES io2/GPIO_J1: J5.26, U4.J1 (IO3_14B)
/ICENES io2/GPIO_J2: J5.25, U4.J2 (IO3_14A)
/ICENES io2/GPIO_J4: J5.29, U4.J4 (IO3_11A)
/ICENES io2/GPIO_J5: J5.27, U4.J5 (IO3_12A)
/ICENES io2/GPIO_K1: J5.23, U4.K1 (IO3_15A)
/ICENES io2/GPIO_K3: J5.24, U4.K3 (IO3_15B)
/ICENES io2/GPIO_K4: J5.19, U4.K4 (IO3_17A)
/ICENES io2/GPIO_K5: J5.15, U4.K5 (IO3_19A)
/ICENES io2/GPIO_K9: J5.33, U4.K9 (GBIN4/IO2_27)
/ICENES io2/GPIO_L1: J5.22, U4.L1 (IO3_16B)
/ICENES io2/GPIO_L3: J5.18, U4.L3 (IO3_18B)
/ICENES io2/GPIO_L4: J5.21, U4.L4 (IO3_16A)
/ICENES io2/GPIO_L5: J5.9, U4.L5 (IO3_22A)
/ICENES io2/GPIO_L6: J5.17, U4.L6 (IO3_18A)
/ICENES io2/GPIO_L7: J5.13, U4.L7 (IO3_20A)
/ICENES io2/GPIO_L9: J4.43, U4.L9 (IO2_19)
/ICENES io2/GPIO_L10: J4.44, U4.L10 (IO2_30)
/ICENES io2/GPIO_L11: J4.51, U4.L11 (IO2_40)
/ICENES io2/GPIO_M1: J5.20, U4.M1 (IO3_17B)
/ICENES io2/GPIO_M2: J5.16, U4.M2 (IO3_19B)
/ICENES io2/GPIO_M3: J5.12, U4.M3 (IO3_21B)
/ICENES io2/GPIO_M4: J5.8, U4.M4 (IO3_23B)
/ICENES io2/GPIO_M5: J4.8, U4.M5 (IO3_24B)
/ICENES io2/GPIO_M6: J5.11, U4.M6 (IO3_21A)
/ICENES io2/GPIO_M7: J4.10, U4.M7 (IO2_11)
/ICENES io2/GPIO_M8: J4.12, U4.M8 (IO2_14)
/ICENES io2/GPIO_M9: J4.46, U4.M9 (IO2_25)
/ICENES io2/GPIO_M11: J4.49, U4.M11 (IO2_37)
/ICENES io2/GPIO_M12: J4.52, U4.M12 (IO2_42)
/ICENES io2/GPIO_N2: J5.14, U4.N2 (IO3_20B)
/ICENES io2/GPIO_N3: J5.10, U4.N3 (IO3_22B)
/ICENES io2/GPIO_N4: J4.7, U4.N4 (IO3_25B)
/ICENES io2/GPIO_N5: J3.16, U4.N5 (IO2_04)
/ICENES io2/GPIO_N6: J4.9, U4.N6 (IO2_00)
/ICENES io2/GPIO_N7: J4.11, U4.N7 (IO2_12)
/ICENES io2/GPIO_N10: J4.45, U4.N10 (IO2_32)
/ICENES io2/GPIO_N12: J4.50, U4.N12 (IO2_39)
/ICENES io2/GPIO_P1: J5.7, U4.P1 (IO3_23A)
/ICENES io2/GPIO_P2: J3.10, U4.P2 (IO3_24A)
/ICENES io2/GPIO_P4: J3.14, U4.P4 (IO2_02)
/ICENES io2/GPIO_P5: J3.18, U4.P5 (IO2_06)
/ICENES io2/GPIO_P6: J3.19, U4.P6 (IO2_13)
/ICENES io2/GPIO_P10: J4.14, U4.P10 (IO2_31)
/ICENES io2/GPIO_P13: J4.18, U4.P13 (IO2_45/CBSEL1)
/ICENES io2/GPIO_R1: J3.8, U4.R1 (IO3_25A)
/ICENES io2/GPIO_R2: J3.9, U4.R2 (IO2_03)
/ICENES io2/GPIO_R3: J3.11, U4.R3 (IO2_07)
/ICENES io2/GPIO_R4: J3.15, U4.R4 (IO2_10)
/ICENES io2/GPIO_R5: J3.17, U4.R5 (IO2_08)
/ICENES io2/GPIO_R6: J3.22, U4.R6 (IO2_16)
/ICENES io2/GPIO_R10: J4.15, U4.R10 (IO2_29)
/ICENES io2/GPIO_R16: J4.25, U4.R16 (IO2_43)
/ICENES io2/GPIO_T1: J3.7, U4.T1 (IO2_01)
/ICENES io2/GPIO_T2: J3.12, U4.T2 (IO2_05)
/ICENES io2/GPIO_T3: J3.13, U4.T3 (IO2_09)
/ICENES io2/GPIO_T5: J3.20, U4.T5 (IO2_15)
/ICENES io2/GPIO_T6: J3.21, U4.T6 (IO2_18)
/ICENES io2/GPIO_T10: J4.16, U4.T10 (IO2_33)
/ICENES io2/GPIO_T11: J4.13, U4.T11 (IO2_34)
/ICENES io2/GPIO_T13: J4.17, U4.T13 (IO2_38)
/ICENES io2/GPIO_T14: J4.19, U4.T14 (IO2_36)
/ICENES io2/GPIO_T15: J4.21, U4.T15 (IO2_35)
/ICENES io2/GPIO_T16: J4.23, U4.T16 (IO2_41)
CTSn: U4.T8 (IO2_21); also elsewhere on the board
DCDn: U4.P7 (IO2_22); also elsewhere on the board
DSRn: U4.T7 (IO2_20); also elsewhere on the board
DTRn: U4.P8 (IO2_17); also elsewhere on the board
GND: C60.2, C62.2, C64.2, C65.2, C66.2, C67.1, C68.2, C69.2, C70.2, C71.1, C72.2, C75.2, C77.2, C78.1, C79.2, C80.2, C81.1, C82.2, C83.2, C84.2, C85.1, C86.2, C87.2, C88.2, C89.1, J3.2, J3.4, J3.6, J4.2, J4.4, J4.6, J4.32, J4.34, J4.58, J4.60, J4.62, J5.2, J5.4, J5.6, J5.32, J5.34, J5.58, J5.60, J5.62; also elsewhere on the board
GPIO_J10: J4.41; also elsewhere on the board
GPIO_J14: J4.42; also elsewhere on the board
GPIO_J15: J4.48; also elsewhere on the board
GPIO_J16: J4.47; also elsewhere on the board
GPIO_K12: J4.55; also elsewhere on the board
GPIO_K13: J4.56; also elsewhere on the board
GPIO_K14: J4.37; also elsewhere on the board
GPIO_K15: J4.40; also elsewhere on the board
GPIO_K16: J4.39; also elsewhere on the board
GPIO_L12: J4.53; also elsewhere on the board
GPIO_L13: J4.54; also elsewhere on the board
GPIO_L14: J4.35; also elsewhere on the board
GPIO_L16: J4.38; also elsewhere on the board
GPIO_M13: J4.27; also elsewhere on the board
GPIO_M14: J4.30; also elsewhere on the board
GPIO_M15: J4.33; also elsewhere on the board
GPIO_M16: J4.36; also elsewhere on the board
GPIO_N16: J4.29; also elsewhere on the board
GPIO_P14: J4.24; also elsewhere on the board
GPIO_P15: J4.26; also elsewhere on the board
GPIO_P16: J4.28; also elsewhere on the board
GPIO_R14: J4.20; also elsewhere on the board
GPIO_R15: J4.22; also elsewhere on the board
ICE_CLK_12MHZ: U4.R9 (GBIN5/IO2_26); also elsewhere on the board
ICE_CLK_26.601712MHz: U4.G1 (GBIN7/IO3_12B); also elsewhere on the board
ICE_M2: U4.K11 (IO2_44/CBSEL0); also elsewhere on the board
unnamed: C73.2, C76.2, U4.N8 (GNDPLL1)
RS232_RX_TTL: U4.N9 (IO2_23); also elsewhere on the board
RS232_TX_TTL: U4.P9 (IO2_28); also elsewhere on the board
RTSn: U4.T9 (IO2_24); also elsewhere on the board
iCE_CREST: R37.2, TP17.1, U4.N11 (CRESET_B); also elsewhere on the board
iCE_DONE: R36.2, TP16.1, U4.M10 (CDONE); also elsewhere on the board

Notes on the sheet:
Rough estimation for max resistance is about 13k. Try with 10k to begin with. If 10k does no work move down to 6.04k, 4.7k, 2.2k. 1.54k. 698, 200.

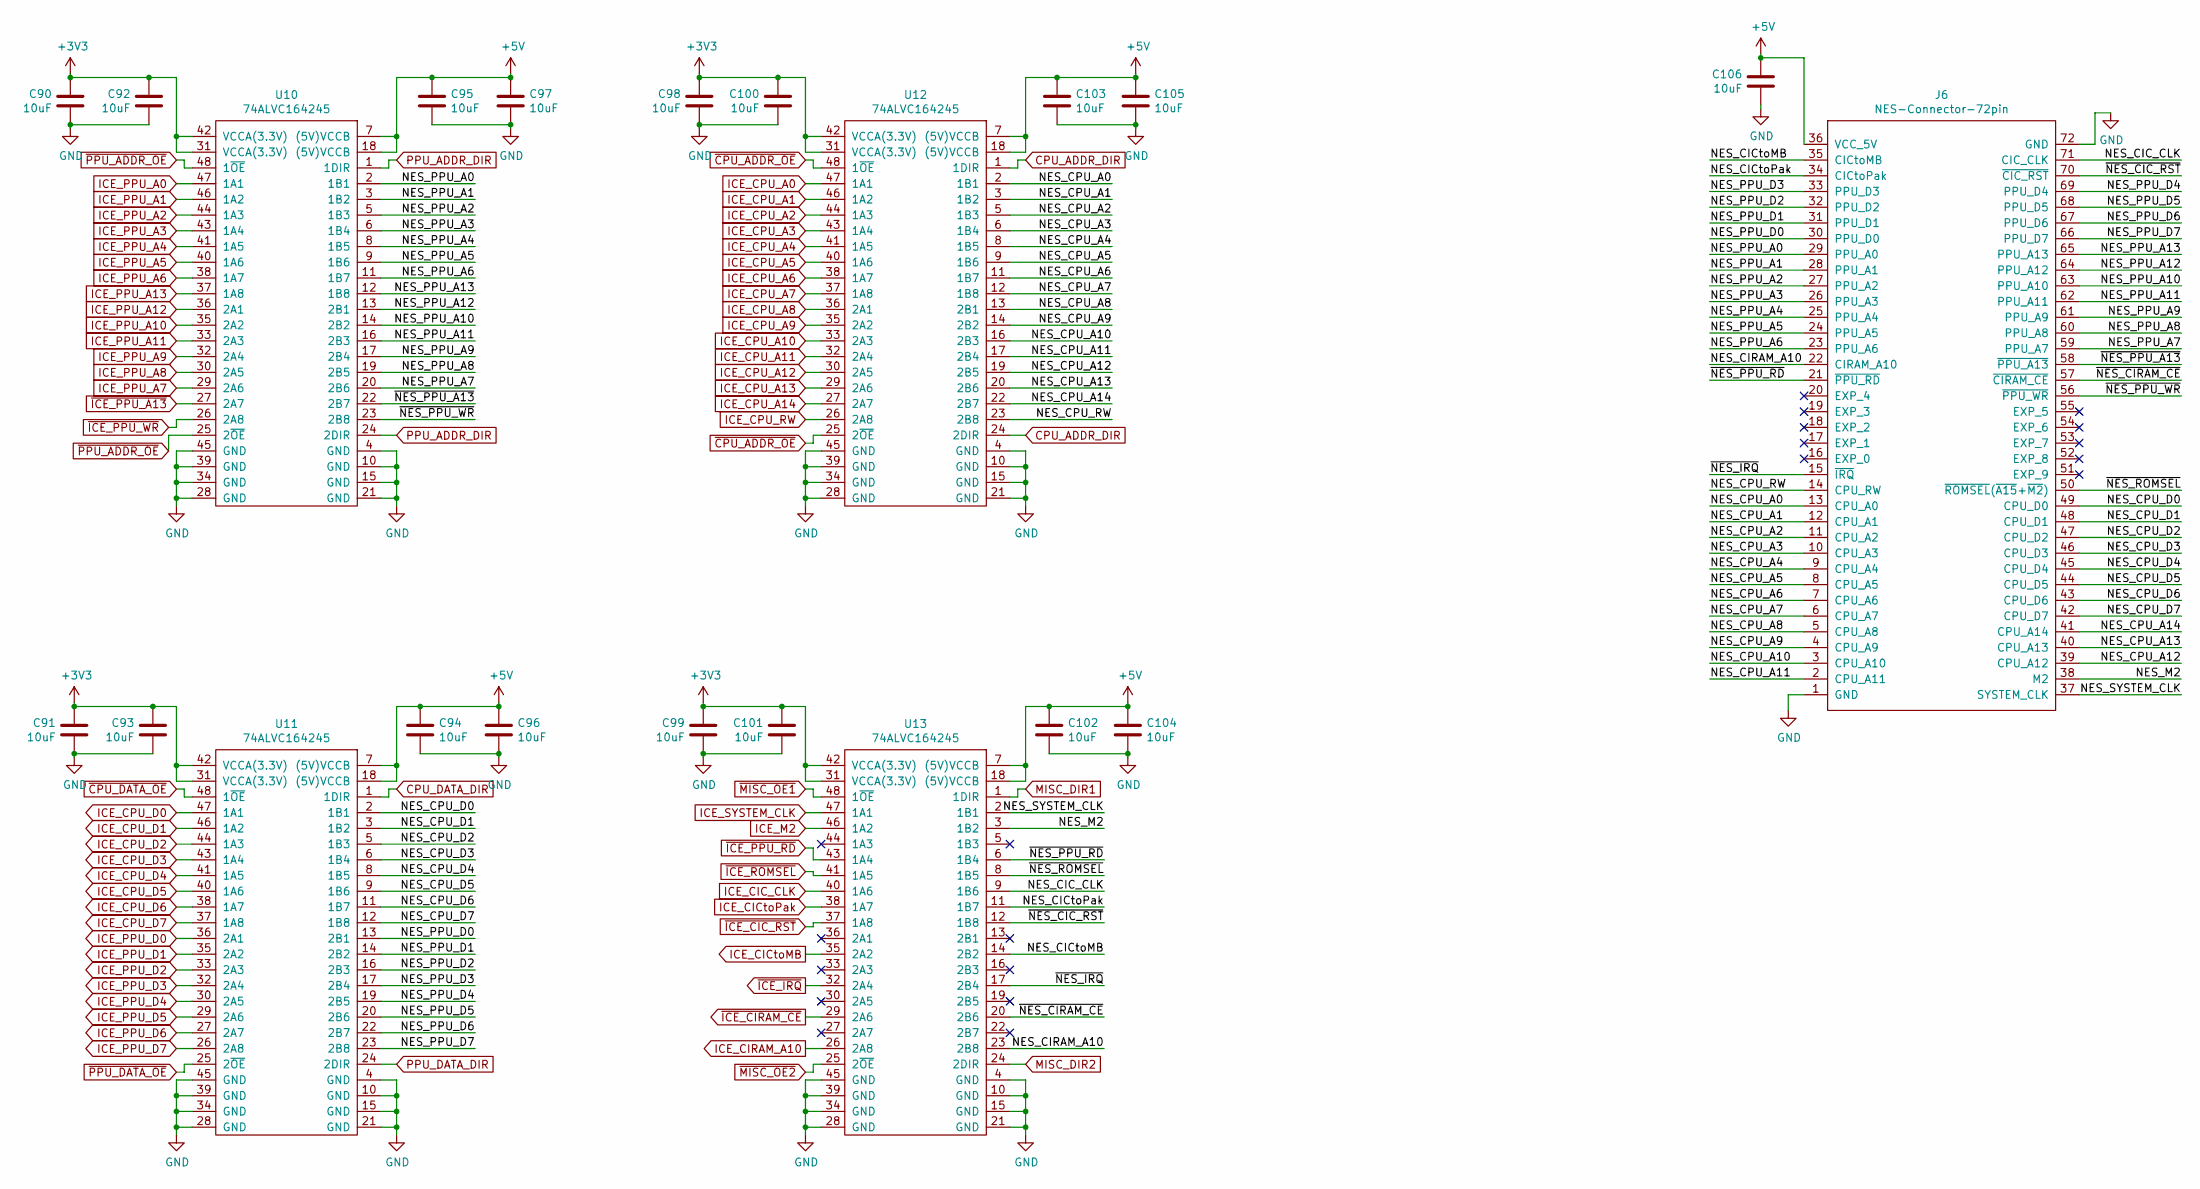
[picture p5: schematic icenes-nes-connector.sch]

Parts:
C90, C91, C92, C93, C94, C95, C96, C97, C98, C99, C100, C101, C102, C103, C104, C105, C106: C10uF; C_0603_1608Metric_Pad1.05x0.95mm_HandSolder; Part number GRM188R61A106KE69D
J6: NES-Connector-72pin; DIP-72-NES-CONNECTOR
U10, U11, U12, U13: 74ALVC164245; TSSOP-48_6.1x12.5mm_P0.5mm; Part number 74ALVC164245PAG8

Connections:
+3V3: C90.2, C91.2, C92.2, C93.2, C98.2, C99.2, C100.2, C101.2, U10.31 (VCCA(3.3V)), U10.42 (VCCA(3.3V)), U11.31 (VCCA(3.3V)), U11.42 (VCCA(3.3V)), U12.31 (VCCA(3.3V)), U12.42 (VCCA(3.3V)), U13.31 (VCCA(3.3V)), U13.42 (VCCA(3.3V)); also elsewhere on the board
+5V: C94.1, C95.1, C96.1, C97.1, C102.1, C103.1, C104.1, C105.1, C106.2, J6.36 (VCC_5V), U10.7 ((5V)VCCB), U10.18 ((5V)VCCB), U11.7 ((5V)VCCB), U11.18 ((5V)VCCB), U12.7 ((5V)VCCB), U12.18 ((5V)VCCB), U13.7 ((5V)VCCB), U13.18 ((5V)VCCB); also elsewhere on the board
/ICENES NES Connector/NES_CIC_CLK: J6.71 (CIC_CLK), U13.9 (1B6)
/ICENES NES Connector/NES_CICtoMB: J6.35 (CICtoMB), U13.14 (2B2)
/ICENES NES Connector/NES_CICtoPak: J6.34 (CICtoPak), U13.11 (1B7)
/ICENES NES Connector/NES_CIRAM_A10: J6.22 (CIRAM_A10), U13.23 (2B8)
/ICENES NES Connector/NES_CPU_A0: J6.13 (CPU_A0), U12.2 (1B1)
/ICENES NES Connector/NES_CPU_A1: J6.12 (CPU_A1), U12.3 (1B2)
/ICENES NES Connector/NES_CPU_A2: J6.11 (CPU_A2), U12.5 (1B3)
/ICENES NES Connector/NES_CPU_A3: J6.10 (CPU_A3), U12.6 (1B4)
/ICENES NES Connector/NES_CPU_A4: J6.9 (CPU_A4), U12.8 (1B5)
/ICENES NES Connector/NES_CPU_A5: J6.8 (CPU_A5), U12.9 (1B6)
/ICENES NES Connector/NES_CPU_A6: J6.7 (CPU_A6), U12.11 (1B7)
/ICENES NES Connector/NES_CPU_A7: J6.6 (CPU_A7), U12.12 (1B8)
/ICENES NES Connector/NES_CPU_A8: J6.5 (CPU_A8), U12.13 (2B1)
/ICENES NES Connector/NES_CPU_A9: J6.4 (CPU_A9), U12.14 (2B2)
/ICENES NES Connector/NES_CPU_A10: J6.3 (CPU_A10), U12.16 (2B3)
/ICENES NES Connector/NES_CPU_A11: J6.2 (CPU_A11), U12.17 (2B4)
/ICENES NES Connector/NES_CPU_A12: J6.39 (CPU_A12), U12.19 (2B5)
/ICENES NES Connector/NES_CPU_A13: J6.40 (CPU_A13), U12.20 (2B6)
/ICENES NES Connector/NES_CPU_A14: J6.41 (CPU_A14), U12.22 (2B7)
/ICENES NES Connector/NES_CPU_D0: J6.49 (CPU_D0), U11.2 (1B1)
/ICENES NES Connector/NES_CPU_D1: J6.48 (CPU_D1), U11.3 (1B2)
/ICENES NES Connector/NES_CPU_D2: J6.47 (CPU_D2), U11.5 (1B3)
/ICENES NES Connector/NES_CPU_D3: J6.46 (CPU_D3), U11.6 (1B4)
/ICENES NES Connector/NES_CPU_D4: J6.45 (CPU_D4), U11.8 (1B5)
/ICENES NES Connector/NES_CPU_D5: J6.44 (CPU_D5), U11.9 (1B6)
/ICENES NES Connector/NES_CPU_D6: J6.43 (CPU_D6), U11.11 (1B7)
/ICENES NES Connector/NES_CPU_D7: J6.42 (CPU_D7), U11.12 (1B8)
/ICENES NES Connector/NES_CPU_RW: J6.14 (CPU_RW), U12.23 (2B8)
/ICENES NES Connector/NES_M2: J6.38 (M2), U13.3 (1B2)
/ICENES NES Connector/NES_PPU_A0: J6.29 (PPU_A0), U10.2 (1B1)
/ICENES NES Connector/NES_PPU_A1: J6.28 (PPU_A1), U10.3 (1B2)
/ICENES NES Connector/NES_PPU_A2: J6.27 (PPU_A2), U10.5 (1B3)
/ICENES NES Connector/NES_PPU_A3: J6.26 (PPU_A3), U10.6 (1B4)
/ICENES NES Connector/NES_PPU_A4: J6.25 (PPU_A4), U10.8 (1B5)
/ICENES NES Connector/NES_PPU_A5: J6.24 (PPU_A5), U10.9 (1B6)
/ICENES NES Connector/NES_PPU_A6: J6.23 (PPU_A6), U10.11 (1B7)
/ICENES NES Connector/NES_PPU_A7: J6.59 (PPU_A7), U10.20 (2B6)
/ICENES NES Connector/NES_PPU_A8: J6.60 (PPU_A8), U10.19 (2B5)
/ICENES NES Connector/NES_PPU_A9: J6.61 (PPU_A9), U10.17 (2B4)
/ICENES NES Connector/NES_PPU_A10: J6.63 (PPU_A10), U10.14 (2B2)
/ICENES NES Connector/NES_PPU_A11: J6.62 (PPU_A11), U10.16 (2B3)
/ICENES NES Connector/NES_PPU_A12: J6.64 (PPU_A12), U10.13 (2B1)
/ICENES NES Connector/NES_PPU_A13: J6.65 (PPU_A13), U10.12 (1B8)
/ICENES NES Connector/NES_PPU_D0: J6.30 (PPU_D0), U11.13 (2B1)
/ICENES NES Connector/NES_PPU_D1: J6.31 (PPU_D1), U11.14 (2B2)
/ICENES NES Connector/NES_PPU_D2: J6.32 (PPU_D2), U11.16 (2B3)
/ICENES NES Connector/NES_PPU_D3: J6.33 (PPU_D3), U11.17 (2B4)
/ICENES NES Connector/NES_PPU_D4: J6.69 (PPU_D4), U11.19 (2B5)
/ICENES NES Connector/NES_PPU_D5: J6.68 (PPU_D5), U11.20 (2B6)
/ICENES NES Connector/NES_PPU_D6: J6.67 (PPU_D6), U11.22 (2B7)
/ICENES NES Connector/NES_PPU_D7: J6.66 (PPU_D7), U11.23 (2B8)
/ICENES NES Connector/NES_SYSTEM_CLK: J6.37 (SYSTEM_CLK), U13.2 (1B1)
/ICENES NES Connector/~NES_CIC_RST: J6.70 (~CIC_RST), U13.12 (1B8)
/ICENES NES Connector/~NES_CIRAM_CE: J6.57 (~CIRAM_CE), U13.20 (2B6)
/ICENES NES Connector/~NES_IRQ: J6.15 (~IRQ), U13.17 (2B4)
/ICENES NES Connector/~NES_PPU_A13: J6.58 (~PPU_A13), U10.22 (2B7)
/ICENES NES Connector/~NES_PPU_RD: J6.21 (~PPU_RD), U13.6 (1B4)
/ICENES NES Connector/~NES_PPU_WR: J6.56 (~PPU_WR), U10.23 (2B8)
/ICENES NES Connector/~NES_ROMSEL: J6.50 (~ROMSEL~(~A15~+~M2~)), U13.8 (1B5)
CPU_ADDR_DIR: U12.1 (1DIR), U12.24 (2DIR); also elsewhere on the board
CPU_DATA_DIR: U11.1 (1DIR); also elsewhere on the board
GND: C90.1, C91.1, C92.1, C93.1, C94.2, C95.2, C96.2, C97.2, C98.1, C99.1, C100.1, C101.1, C102.2, C103.2, C104.2, C105.2, C106.1, J6.1 (GND), J6.72 (GND), U10.4 (GND), U10.10 (GND), U10.15 (GND), U10.21 (GND), U10.28 (GND), U10.34 (GND), U10.39 (GND), U10.45 (GND), U11.4 (GND), U11.10 (GND), U11.15 (GND), U11.21 (GND), U11.28 (GND), U11.34 (GND), U11.39 (GND), U11.45 (GND), U12.4 (GND), U12.10 (GND), U12.15 (GND), U12.21 (GND), U12.28 (GND), U12.34 (GND), U12.39 (GND), U12.45 (GND), U13.4 (GND), U13.10 (GND), U13.15 (GND), U13.21 (GND), U13.28 (GND), U13.34 (GND), U13.39 (GND), U13.45 (GND); also elsewhere on the board
ICE_CIC_CLK: U13.40 (1A6); also elsewhere on the board
ICE_CICtoMB: U13.35 (2A2); also elsewhere on the board
ICE_CICtoPak: U13.38 (1A7); also elsewhere on the board
ICE_CIRAM_A10: U13.26 (2A8); also elsewhere on the board
ICE_CPU_A0: U12.47 (1A1); also elsewhere on the board
ICE_CPU_A1: U12.46 (1A2); also elsewhere on the board
ICE_CPU_A2: U12.44 (1A3); also elsewhere on the board
ICE_CPU_A3: U12.43 (1A4); also elsewhere on the board
ICE_CPU_A4: U12.41 (1A5); also elsewhere on the board
ICE_CPU_A5: U12.40 (1A6); also elsewhere on the board
ICE_CPU_A6: U12.38 (1A7); also elsewhere on the board
ICE_CPU_A7: U12.37 (1A8); also elsewhere on the board
ICE_CPU_A8: U12.36 (2A1); also elsewhere on the board
ICE_CPU_A9: U12.35 (2A2); also elsewhere on the board
ICE_CPU_A10: U12.33 (2A3); also elsewhere on the board
ICE_CPU_A11: U12.32 (2A4); also elsewhere on the board
ICE_CPU_A12: U12.30 (2A5); also elsewhere on the board
ICE_CPU_A13: U12.29 (2A6); also elsewhere on the board
ICE_CPU_A14: U12.27 (2A7); also elsewhere on the board
ICE_CPU_D0: U11.47 (1A1); also elsewhere on the board
ICE_CPU_D1: U11.46 (1A2); also elsewhere on the board
ICE_CPU_D2: U11.44 (1A3); also elsewhere on the board
ICE_CPU_D3: U11.43 (1A4); also elsewhere on the board
ICE_CPU_D4: U11.41 (1A5); also elsewhere on the board
ICE_CPU_D5: U11.40 (1A6); also elsewhere on the board
ICE_CPU_D6: U11.38 (1A7); also elsewhere on the board
ICE_CPU_D7: U11.37 (1A8); also elsewhere on the board
ICE_CPU_RW: U12.26 (2A8); also elsewhere on the board
ICE_M2: U13.46 (1A2); also elsewhere on the board
ICE_PPU_A0: U10.47 (1A1); also elsewhere on the board
ICE_PPU_A1: U10.46 (1A2); also elsewhere on the board
ICE_PPU_A2: U10.44 (1A3); also elsewhere on the board
ICE_PPU_A3: U10.43 (1A4); also elsewhere on the board
ICE_PPU_A4: U10.41 (1A5); also elsewhere on the board
ICE_PPU_A5: U10.40 (1A6); also elsewhere on the board
ICE_PPU_A6: U10.38 (1A7); also elsewhere on the board
ICE_PPU_A7: U10.29 (2A6); also elsewhere on the board
ICE_PPU_A8: U10.30 (2A5); also elsewhere on the board
ICE_PPU_A9: U10.32 (2A4); also elsewhere on the board
ICE_PPU_A10: U10.35 (2A2); also elsewhere on the board
ICE_PPU_A11: U10.33 (2A3); also elsewhere on the board
ICE_PPU_A12: U10.36 (2A1); also elsewhere on the board
ICE_PPU_A13: U10.37 (1A8); also elsewhere on the board
ICE_PPU_D0: U11.36 (2A1); also elsewhere on the board
ICE_PPU_D1: U11.35 (2A2); also elsewhere on the board
ICE_PPU_D2: U11.33 (2A3); also elsewhere on the board
ICE_PPU_D3: U11.32 (2A4); also elsewhere on the board
ICE_PPU_D4: U11.30 (2A5); also elsewhere on the board
ICE_PPU_D5: U11.29 (2A6); also elsewhere on the board
ICE_PPU_D6: U11.27 (2A7); also elsewhere on the board
ICE_PPU_D7: U11.26 (2A8); also elsewhere on the board
ICE_SYSTEM_CLK: U13.47 (1A1); also elsewhere on the board
MISC_DIR1: U13.1 (1DIR); also elsewhere on the board
MISC_DIR2: U13.24 (2DIR); also elsewhere on the board
PPU_ADDR_DIR: U10.1 (1DIR), U10.24 (2DIR); also elsewhere on the board
PPU_DATA_DIR: U11.24 (2DIR); also elsewhere on the board
~CPU_ADDR_OE: U12.25 (2~OE), U12.48 (1~OE); also elsewhere on the board
~CPU_DATA_OE: U11.48 (1~OE); also elsewhere on the board
~ICE_CIC_RST: U13.37 (1A8); also elsewhere on the board
~ICE_CIRAM_CE: U13.29 (2A6); also elsewhere on the board
~ICE_IRQ: U13.32 (2A4); also elsewhere on the board
~ICE_PPU_A13: U10.27 (2A7); also elsewhere on the board
~ICE_PPU_RD: U13.43 (1A4); also elsewhere on the board
~ICE_PPU_WR: U10.26 (2A8); also elsewhere on the board
~ICE_ROMSEL: U13.41 (1A5); also elsewhere on the board
~MISC_OE1: U13.48 (1~OE); also elsewhere on the board
~MISC_OE2: U13.25 (2~OE); also elsewhere on the board
~PPU_ADDR_OE: U10.25 (2~OE), U10.48 (1~OE); also elsewhere on the board
~PPU_DATA_OE: U11.25 (2~OE); also elsewhere on the board

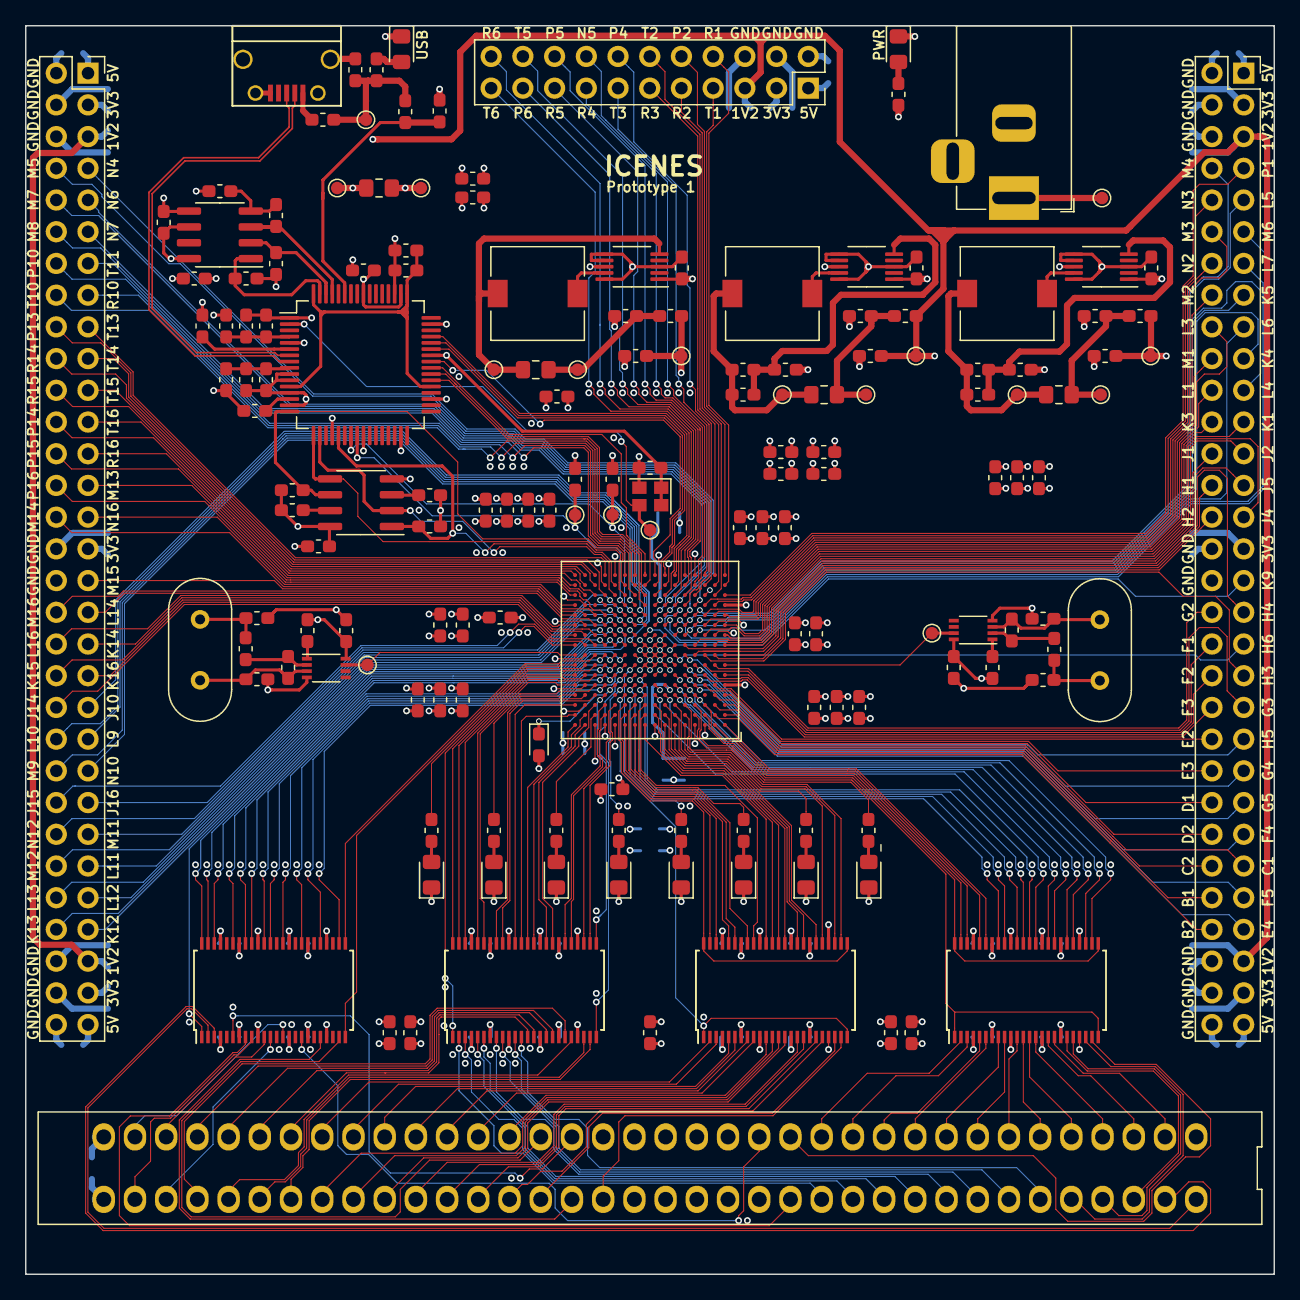
[picture p6: board icenes.kicad_pcb from above]

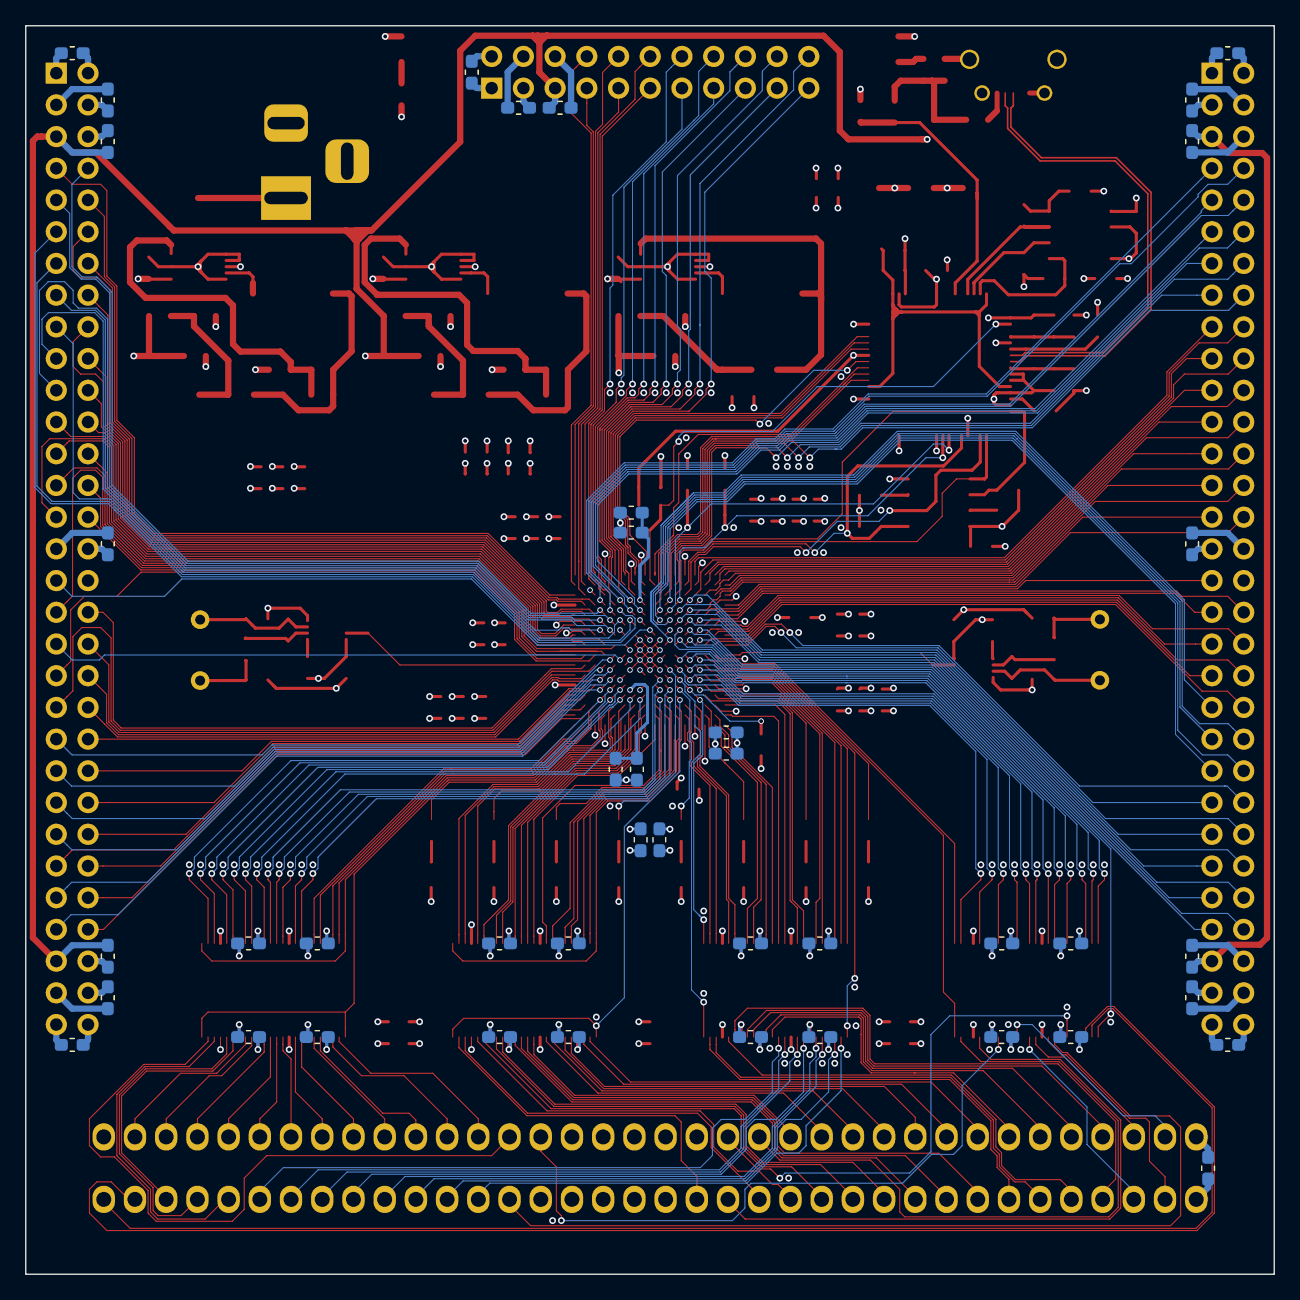
[picture p7: board icenes.kicad_pcb from below]

Board: 6 copper layers, 100.0 x 100.0 mm, 203 parts (42 on the bottom side), 318 nets.
