PJO83/icenes/(commit log)

2019-07-01 Initial commit.
    [iCE40PinoutHX8K.xlsx, icenes-io1.sch, icenes-io2.sch, icenes-nes-connector.sch, icenes-spi-flash.sch, icenes-usb-flash.sch, icenes-usb.sch, icenes.kicad_pcb]
2019-07-01 Moved files to hw fodler.
    [iCE40PinoutHX8K.xlsx, icenes-io1.sch, icenes-io2.sch, icenes-nes-connector.sch, icenes-spi-flash.sch, icenes-usb-flash.sch, icenes-usb.sch, icenes.kicad_pcb]
2019-07-01 Removed unused files and updated name in license.
    [icenes-spi-flash.sch, icenes-usb.sch]
2019-07-27 Added voltage generators for 3.3V, 1.2V and 5V. Added more info and footprints to some components. Connected signals to the NES connector to banks 0 and 1.
    [icenes-io1.sch, icenes-io2.sch, icenes-nes-connector.sch, icenes-usb-flash.sch, icenes.sch]
2019-07-28 Added 8 LED. Added GPIO header for the rest of the GPIO pins on bank1. Labeled all GPIO pins.
    [icenes-io1.sch, icenes-io2.sch]
2019-07-28 Removed unused footprint lib.
2019-07-29 GPIO headers for banks 2 and 3.
    [icenes-io1.sch, icenes-io2.sch, icenes-usb-flash.sch, icenes.sch]
2019-08-25 Completed USB interface. Clock sources for PAL and NTSC frequencies. Added a 133MHz clock (max input to PLL). Some more stuff.
    [icenes-io1.sch, icenes-io2.sch, icenes-nes-connector.sch, icenes-usb-flash.sch, icenes.sch]
2019-08-26 Added missing footprints.
    [icenes.sch]
2019-08-27 Minor fixes.
    [icenes-io1.sch, icenes-io2.sch, icenes-nes-connector.sch, icenes-usb-flash.sch, icenes.sch]
2019-08-27 Fixed all ECR warnings.
    [icenes-io1.sch, icenes-io2.sch, icenes-nes-connector.sch, icenes-usb-flash.sch, icenes.sch]
2019-08-27 Fixed wrong inductor choice.
    [icenes-io1.sch, icenes-io2.sch, icenes-nes-connector.sch, icenes-usb-flash.sch, icenes.sch]
2019-08-27 Removed test points from power good signals.
    [icenes.sch]
2019-08-27 Added voltage range in Vin lable (+5V to +10V).
    [icenes-io1.sch, icenes-io2.sch, icenes-usb-flash.sch, icenes.sch]
2019-08-27 Changed inductor.
    [icenes.sch]
2019-08-28 Added missing footprint for the new inductor. Added 3d models to the barrel jack and oscillators.
    [icenes-usb-flash.sch]
2019-08-28 Connected the chip select pin of the SPI flash to FT2232H and to the FPGA.
    [icenes-usb-flash.sch]
2019-08-31 Fixed incorrect reference between USB_VBUS and +3V3_FTDI
    [icenes.sch]
2019-09-01 Rough board layout.
    [icenes-io2.sch, icenes-nes-connector.sch, icenes-usb-flash.sch, icenes.kicad_pcb]
2019-09-04 layout work.
    [icenes-io2.sch, icenes.kicad_pcb]
2019-09-28 Layout. Added some info for the PAL crystal.
    [icenes-io1.sch, icenes-io2.sch, icenes.kicad_pcb]
2019-10-16 Layout. - Changed footprint of the nes connector from 2.54mm pitch and 5.08mm row pitch to 2.5mm pitch and 0.5mm row pitch.
    [icenes-nes-connector.sch, icenes.kicad_pcb]
2019-10-18 Layout. Cleaned up nes connector footprints. Adjusted LED (D1) series resistor. Adjusted the voltage divider to BCBUS7 on FT2232H. Set pull up resistor to CDONE to 10k.
    [icenes-io1.sch, icenes-io2.sch, icenes-nes-connector.sch, icenes-usb-flash.sch, icenes.kicad_pcb, icenes.sch]
2019-10-22 Added pwr led.
    [icenes.kicad_pcb, icenes.sch]
